AndyBritoS/DC_Motor_Controller/Released Files/ESC_rev0_Back.jpg

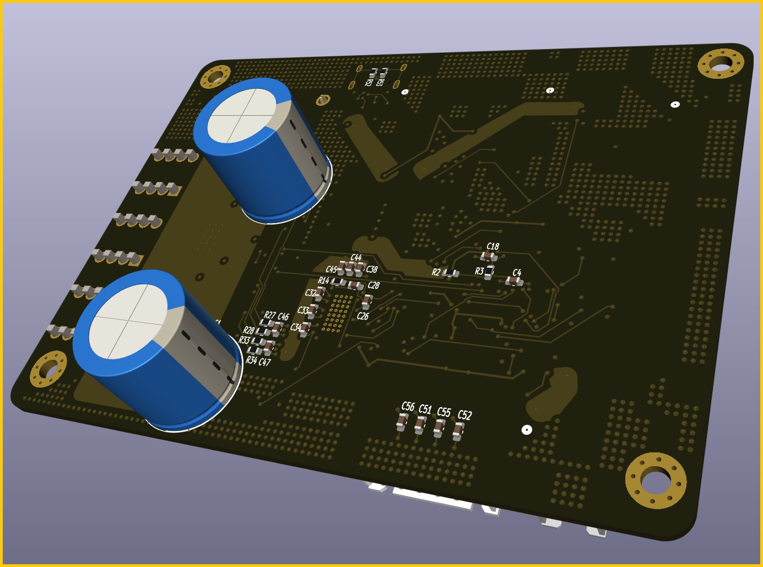
Released Files/ESC_rev0_Back.jpg
