AndyBritoS/DC_Motor_Controller/Released Files/ESC_rev0_RayTracing.jpg

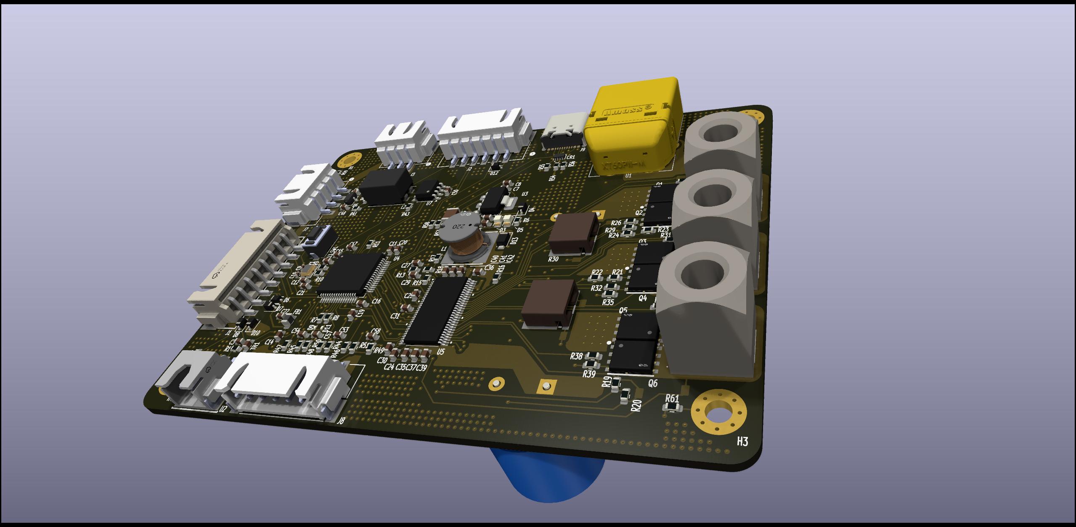
Released Files/ESC_rev0_RayTracing.jpg
