AndyBritoS/DC_Motor_Controller/README.md

# DC_Motor_Controller
DC Motor Controller PCB Project files

This project was made following the PCB Design Mastery course from Fresu Electronics (https://www.fresuelectronics.com/) and it is for demonstration purpose only. The hardware was not built or tested. Some design aspects were ignored.
