AndyBritoS/DC_Motor_Controller/Released Files/ESC_rev0_Front.jpg

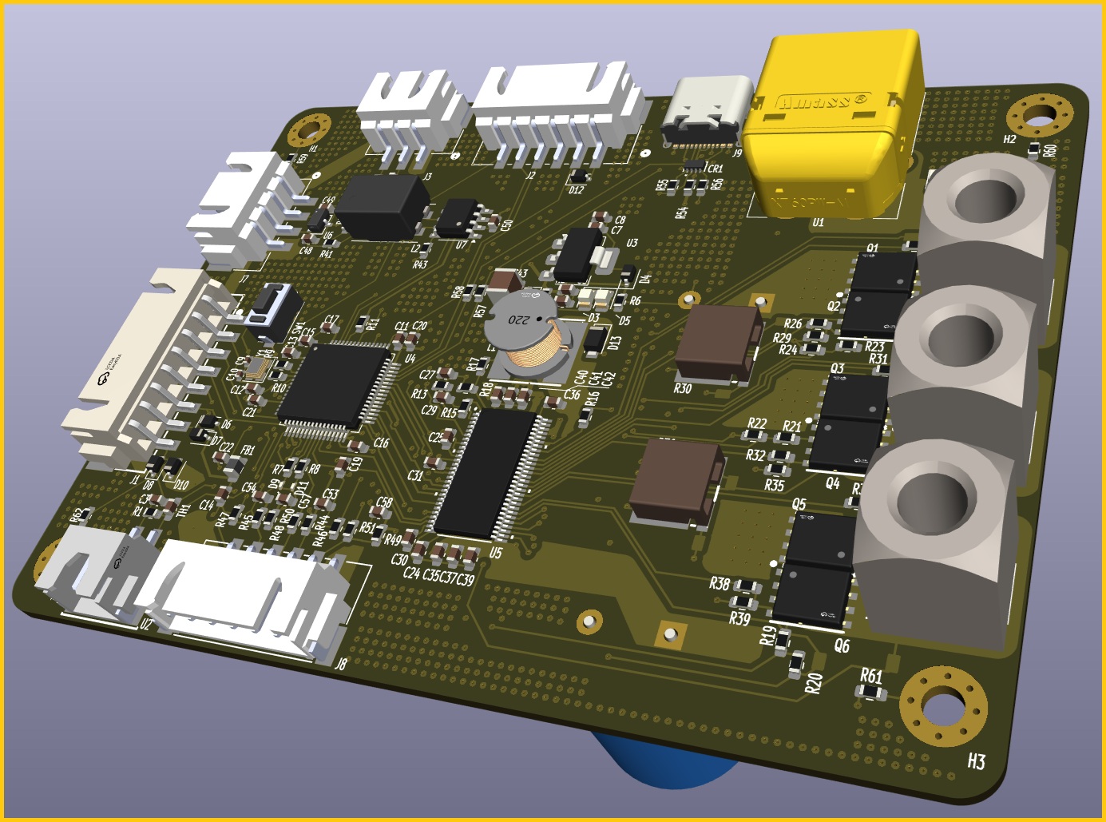
Released Files/ESC_rev0_Front.jpg
