AndyBritoS/DC_Motor_Controller/Released Files/ESC_rev0_RayTracNoSilk.jpg

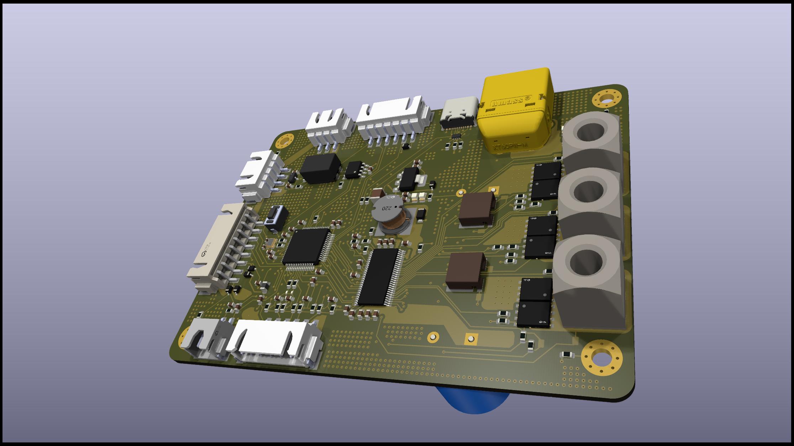
Released Files/ESC_rev0_RayTracNoSilk.jpg
