AndyBritoS/DC_Motor_Controller/Released Files/Layer 1 - Front.png

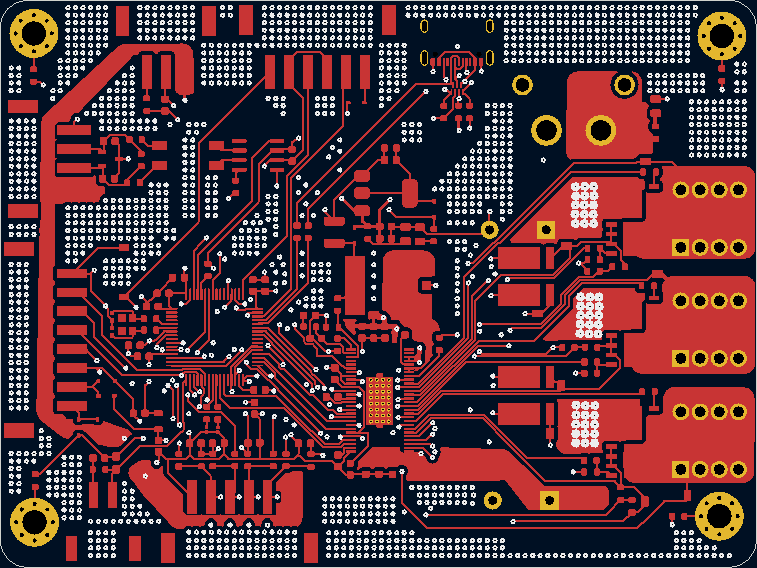
Released Files/Layer 1 - Front.png
