AndyBritoS/DC_Motor_Controller/Released Files/Layer 2 - Inner GND.png

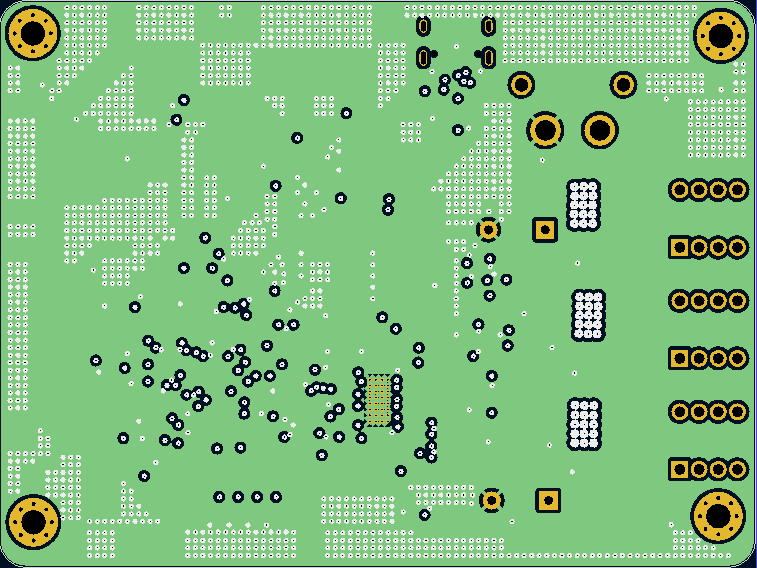
Released Files/Layer 2 - Inner GND.png
