AndyBritoS/DC_Motor_Controller/Released Files/Layer 4 - Back.png

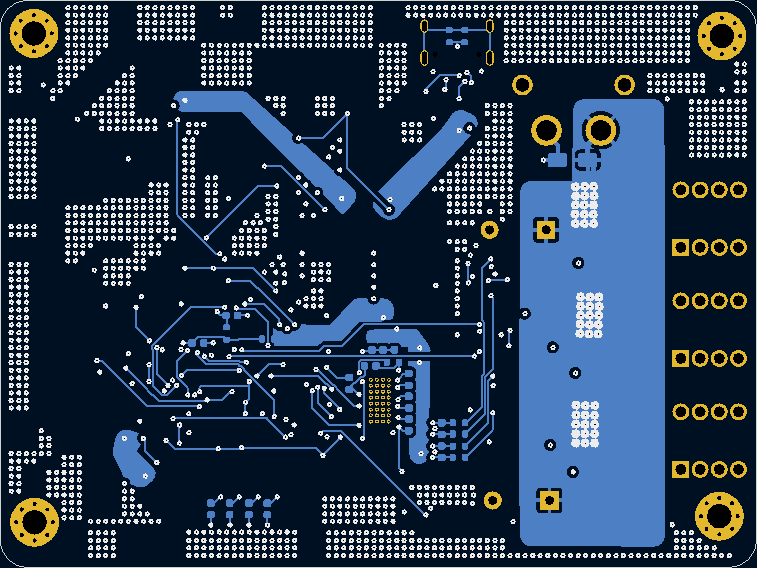
Released Files/Layer 4 - Back.png
