AndyBritoS/DC_Motor_Controller/Design Files/ESC_rev0/ESC_rev0.kicad_pcb

## KiCad design Design Files/ESC_rev0/ESC_rev0.kicad_pcb (2025-01-27)

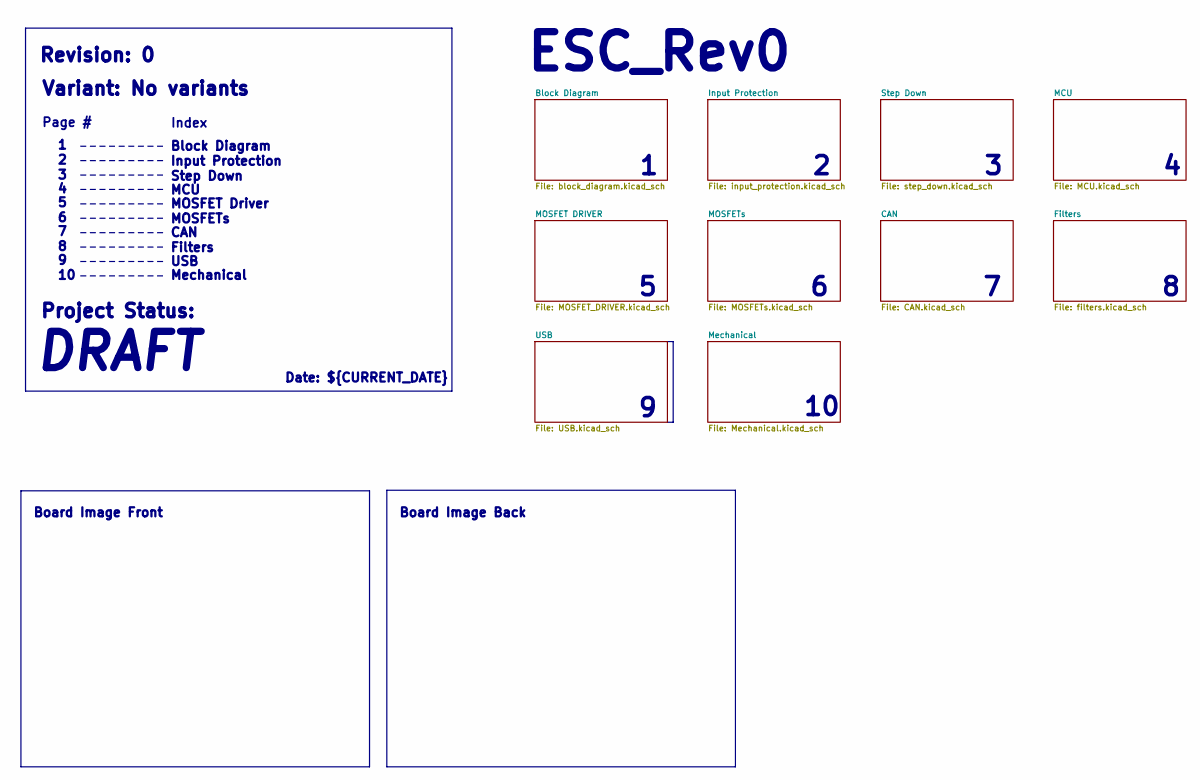
[picture p8: schematic ESC_rev0.kicad_sch]

Notes on the sheet:
MOSFET Driver
${TITLE}
Filters
Block Diagram
Revision: ${REVISION}
USB
Index
DRAFT
Mechanical
Page #
MOSFETs
Step Down
Variant: No variants
CAN
Input Protection
MCU
Board Image Front
Date: ${CURRENT_DATE}
Board Image Back
Project Status:

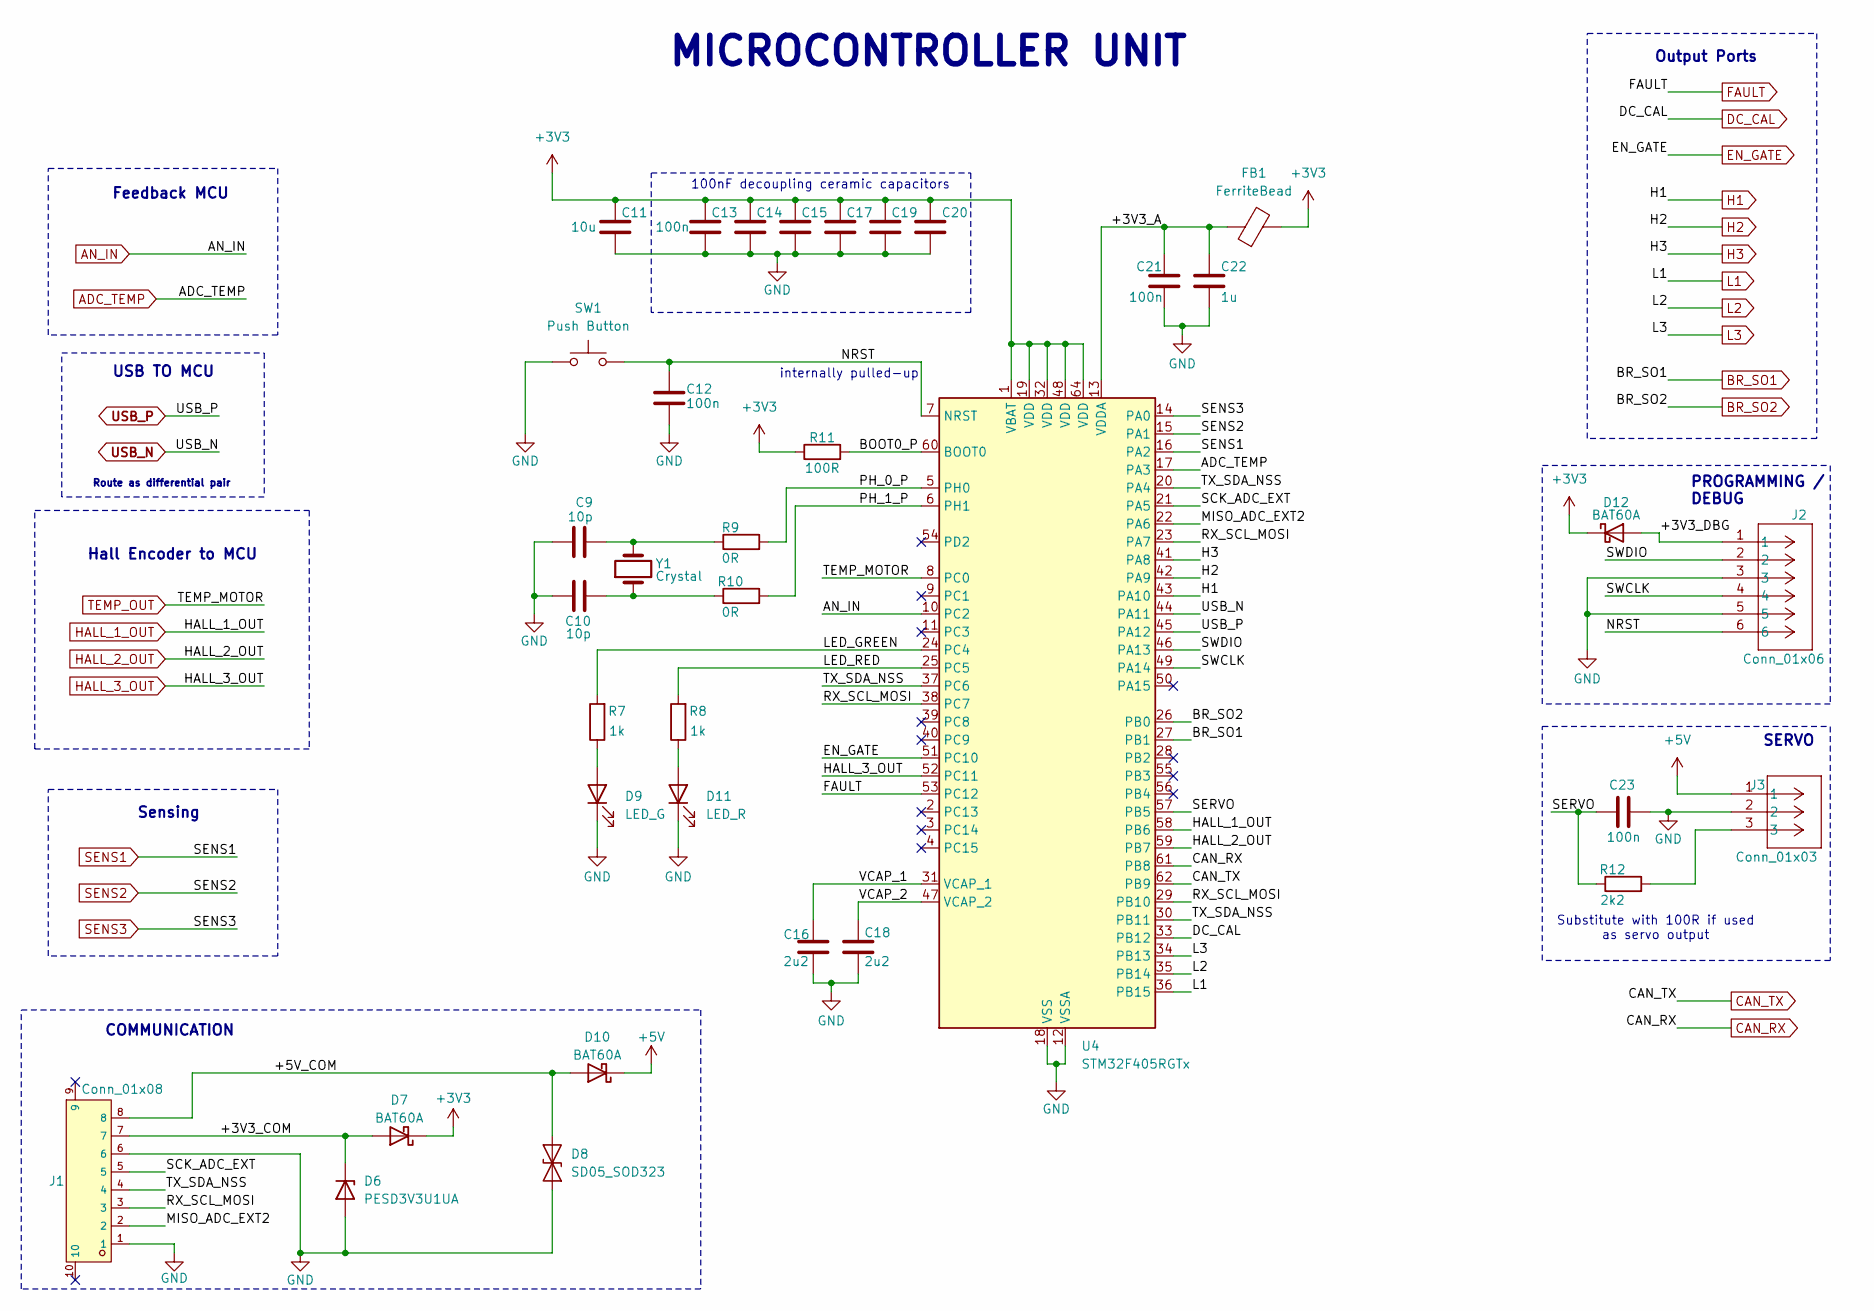
[picture p9: schematic MCU.kicad_sch, MICROCONTROLLER UNIT]

Parts:
C9, C10: 10p; C_0402_1005Metric
C11: 10u; C_0603_1608Metric
C12, C13, C14, C15, C17, C19, C20, C21, C23: 100n; C_0603_1608Metric
C16, C18: 2u2; C_0603_1608Metric
C22: 1u; C_0603_1608Metric
D6: PESD3V3U1UA; D_SOD-323F
D7, D10, D12: BAT60A; D_SOD-323
D8: SD05_SOD323; D_SOD-323
D9: LED_G; LED_0201_0603Metric
D11: LED_R; LED_0201_0603Metric
FB1: FerriteBead; L_0805_2012Metric
J1: Conn_01x08; CONN-SMD_8P-P2.50_HX25003-8AWB; LCSC C442367
J2: Conn_01x06; CONN_S6B-XH-SM4-TB_JST
J3: Conn_01x03; CONN3_S3B-XH_JST
R7, R8: 1k; R_0603_1608Metric
R9, R10: 0R; R_0603_1608Metric
R11: 100R; R_0603_1608Metric
R12: 2k2; R_0603_1608Metric
SW1: Push Button; SW_PTS636_SM43J_SMTR_LFS
U4: STM32F405RGTx; LQFP-64_10x10mm_P0.5mm
Y1: Crystal; Crystal_SMD_2520-4Pin_2.5x2.0mm

Connections:
+3V3: C11.1, C13.1, C14.1, C15.1, C17.1, C19.1, C20.1, D7.1 (K), D12.1 (K), FB1.2, R11.1, U4.1 (VBAT), U4.19 (VDD), U4.32 (VDD), U4.48 (VDD), U4.64 (VDD); also elsewhere on the board
+5V: D10.1 (K), J3.1; also elsewhere on the board
/MCU/+3V3_A: C21.1, C22.1, FB1.1, U4.13 (VDDA)
/MCU/+3V3_COM: D6.1 (K), D7.2 (A), J1.7
/MCU/+3V3_DBG: D12.2 (A), J2.1
/MCU/+5V_COM: D8.2 (A2), D10.2 (A), J1.8
/MCU/BOOT0_P: R11.2, U4.60 (BOOT0)
/MCU/LED_GREEN: R7.2, U4.24 (PC4)
/MCU/LED_RED: R8.2, U4.25 (PC5)
/MCU/MISO_ADC_EXT2: J1.2, U4.22 (PA6)
/MCU/NRST: C12.1, J2.6, SW1.2, U4.7 (NRST)
/MCU/PH_0_P: R9.2, U4.5 (PH0)
/MCU/PH_1_P: R10.2, U4.6 (PH1)
/MCU/RX_SCL_MOSI: J1.3, U4.23 (PA7), U4.29 (PB10), U4.38 (PC7)
/MCU/SCK_ADC_EXT: J1.5, U4.21 (PA5)
/MCU/SERVO: C23.1, R12.1, U4.57 (PB5)
/MCU/SWCLK: J2.4, U4.49 (PA14)
/MCU/SWDIO: J2.2, U4.46 (PA13)
/MCU/TX_SDA_NSS: J1.4, U4.20 (PA4), U4.30 (PB11), U4.37 (PC6)
/MCU/VCAP_1: C16.1, U4.31 (VCAP_1)
/MCU/VCAP_2: C18.1, U4.47 (VCAP_2)
ADC_TEMP: U4.17 (PA3); also elsewhere on the board
AN_IN: U4.10 (PC2); also elsewhere on the board
BR_SO1: U4.27 (PB1); also elsewhere on the board
BR_SO2: U4.26 (PB0); also elsewhere on the board
CAN_RX: U4.61 (PB8); also elsewhere on the board
CAN_TX: U4.62 (PB9); also elsewhere on the board
DC_CAL: U4.33 (PB12); also elsewhere on the board
EN_GATE: U4.51 (PC10); also elsewhere on the board
FAULT: U4.53 (PC12); also elsewhere on the board
GND: C9.1, C10.1, C11.2, C12.2, C13.2, C14.2, C15.2, C16.2, C17.2, C18.2, C19.2, C20.2, C21.2, C22.2, C23.2, D6.2 (A), D8.1 (A1), D9.1 (K), D11.1 (K), J1.1, J1.6, J2.3, J2.5, J3.2, SW1.1, U4.12 (VSSA), U4.18 (VSS), U4.63 (VSS); also elsewhere on the board
H1: U4.43 (PA10); also elsewhere on the board
H2: U4.42 (PA9); also elsewhere on the board
H3: U4.41 (PA8); also elsewhere on the board
HALL_1_OUT: U4.58 (PB6); also elsewhere on the board
HALL_2_OUT: U4.59 (PB7); also elsewhere on the board
HALL_3_OUT: U4.52 (PC11); also elsewhere on the board
L1: U4.36 (PB15); also elsewhere on the board
L2: U4.35 (PB14); also elsewhere on the board
L3: U4.34 (PB13); also elsewhere on the board
unnamed: C9.2, R9.1, Y1.2
unnamed: C10.2, R10.1, Y1.1
unnamed: D9.2 (A), R7.1
unnamed: D11.2 (A), R8.1
unnamed: J3.3, R12.2
SENS1: U4.16 (PA2); also elsewhere on the board
SENS2: U4.15 (PA1); also elsewhere on the board
SENS3: U4.14 (PA0); also elsewhere on the board
TEMP_OUT: U4.8 (PC0); also elsewhere on the board
USB_N: U4.44 (PA11); also elsewhere on the board
USB_P: U4.45 (PA12); also elsewhere on the board

Notes on the sheet:
Substitute with 100R if used as servo output
internally pulled-up
Hall Encoder to MCU
Output Ports
USB TO MCU
Feedback MCU
PROGRAMMING / DEBUG
SERVO
${TITLE}
COMMUNICATION
100nF decoupling ceramic capacitors
Route as differential pair
Sensing

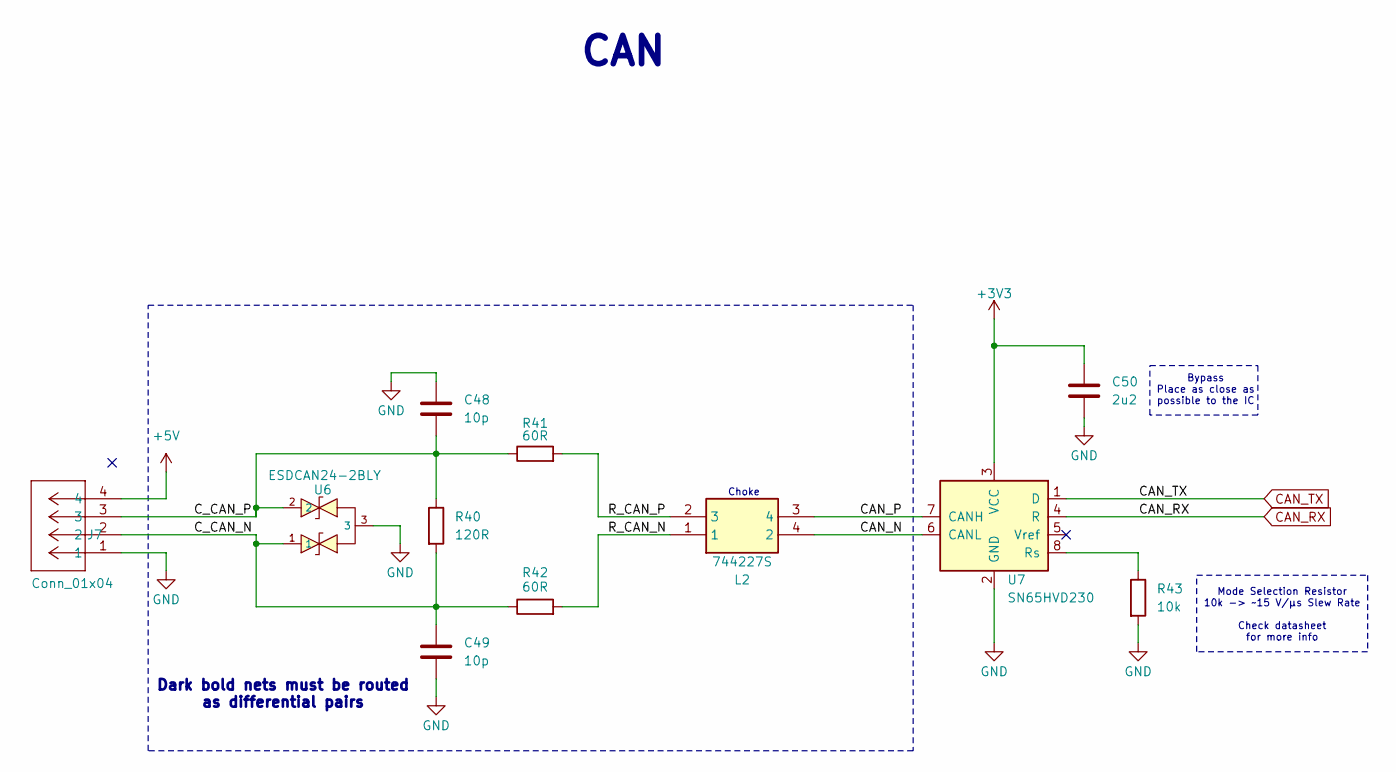
[picture p10: schematic CAN.kicad_sch]

Parts:
C48, C49: 10p; C_0603_1608Metric
C50: 2u2; C_0603_1608Metric
J7: Conn_01x04; CONN4_S4B-XH_JST
L2: 744227S; WE-SL274; Manufacturer_Part_Number 744227S; Mouser Part Number 710-744227S
R40: 120R; R_0603_1608Metric
R41, R42: 60R; R_0603_1608Metric
R43: 10k; R_0603_1608Metric
U6: ESDCAN24-2BLY; SOT-23-3_L3.0-W1.7-P0.95-LS2.9-BR; LCSC C246766
U7: SN65HVD230; SOIC-8_3.9x4.9mm_P1.27mm

Connections:
+3V3: C50.1, U7.3 (VCC); also elsewhere on the board
+5V: J7.4; also elsewhere on the board
/CAN/CAN_N: L2.4 (2), U7.6 (CANL)
/CAN/CAN_P: L2.3 (4), U7.7 (CANH)
/CAN/C_CAN_N: C49.1, J7.2, R40.2, R42.1, U6.1
/CAN/C_CAN_P: C48.2, J7.3, R40.1, R41.1, U6.2
/CAN/R_CAN_N: L2.1, R42.2
/CAN/R_CAN_P: L2.2 (3), R41.2
CAN_RX: U7.4 (R); also elsewhere on the board
CAN_TX: U7.1 (D); also elsewhere on the board
GND: C48.1, C49.2, C50.2, J7.1, R43.2, U6.3, U7.2 (GND); also elsewhere on the board
unnamed: R43.1, U7.8 (Rs)

Notes on the sheet:
Dark bold nets must be routed as differential pairs
Mode Selection Resistor 10k -> ~15 V/µs Slew Rate Check datasheet for more info
Bypass Place as close as possible to the IC
${TITLE}
Choke

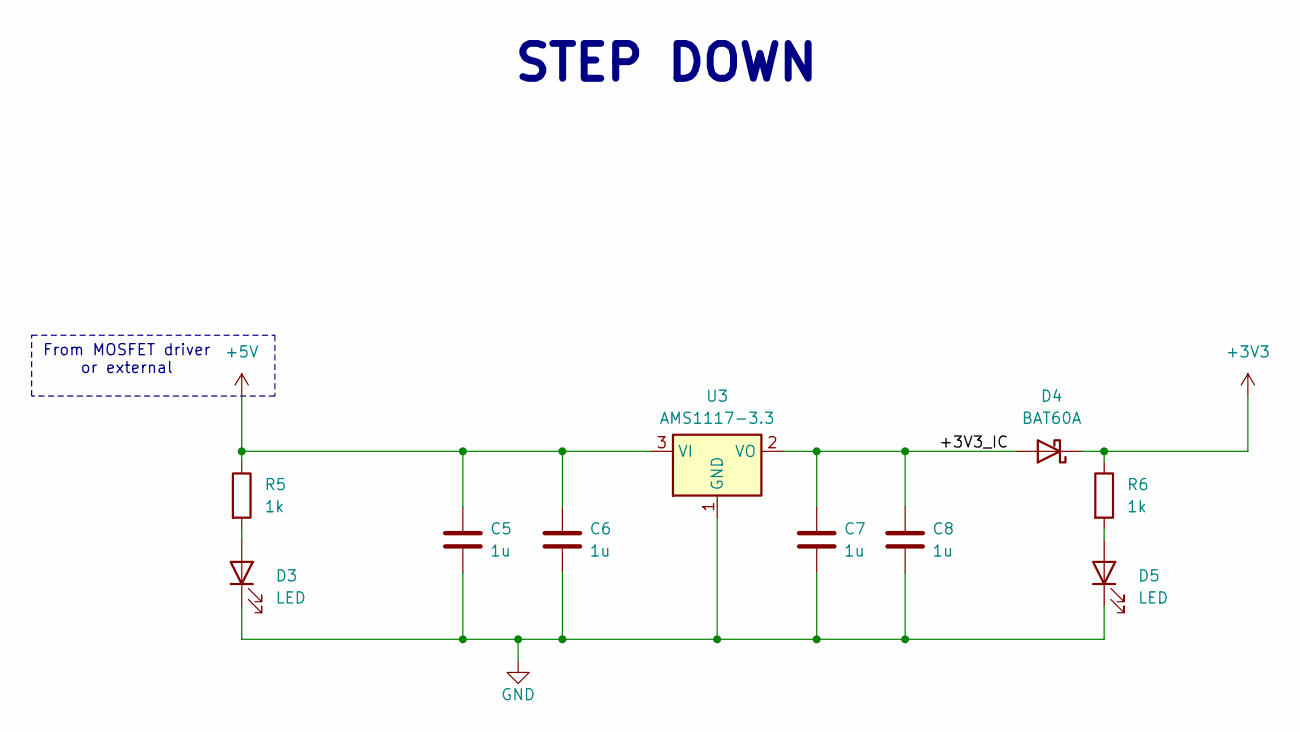
[picture p11: schematic step_down.kicad_sch, STEP DOWN]

Parts:
C5, C6, C7, C8: 1u; C_0603_1608Metric
D3, D5: LED; LED_0805_2012Metric
D4: BAT60A; D_SOD-323
R5, R6: 1k; R_0603_1608Metric
U3: AMS1117-3.3; SOT-223-3_TabPin2

Connections:
+3V3: D4.1 (K), R6.1; also elsewhere on the board
+5V: C5.1, C6.1, R5.1, U3.3 (VI); also elsewhere on the board
/Step Down/+3V3_IC: C7.1, C8.1, D4.2 (A), U3.2 (VO)
GND: C5.2, C6.2, C7.2, C8.2, D3.1 (K), D5.1 (K), U3.1 (GND); also elsewhere on the board
unnamed: D3.2 (A), R5.2
unnamed: D5.2 (A), R6.2

Notes on the sheet:
From MOSFET driver or external
${TITLE}

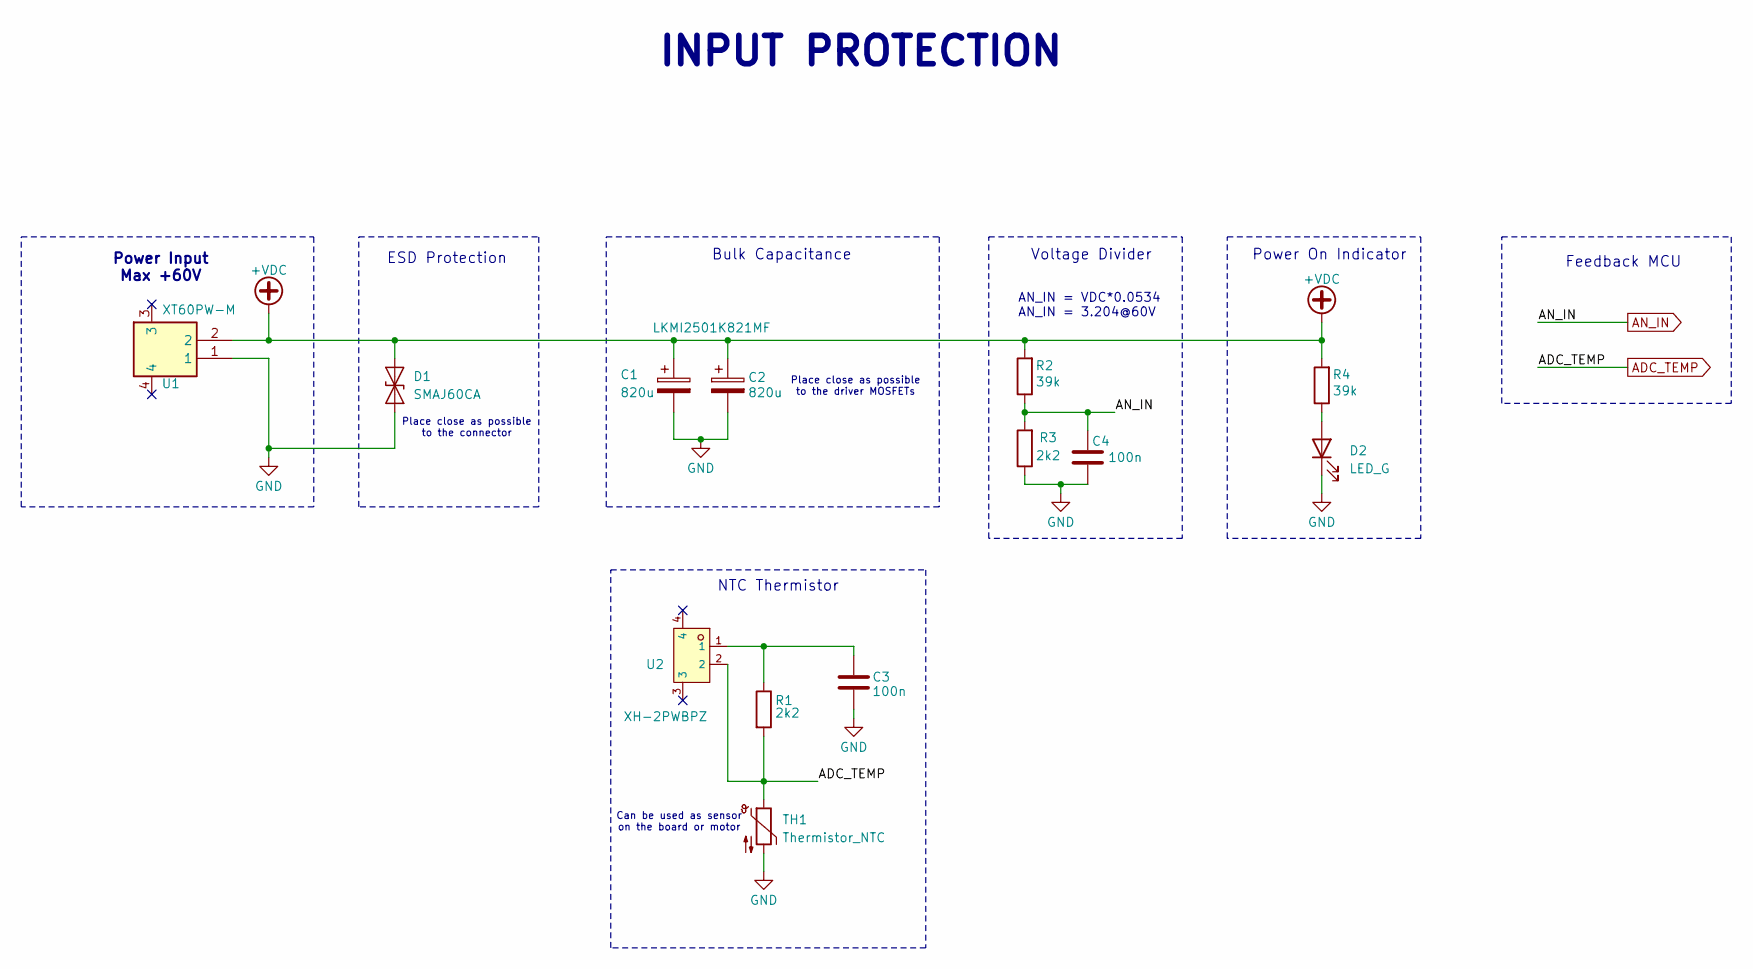
[picture p12: schematic input_protection.kicad_sch, INPUT PROTECTION]

Parts:
C1, C2: 820u; CP_Radial_D16.0mm_P7.50mm
C3, C4: 100n; C_0603_1608Metric
D1: SMAJ60CA; D_SMA
D2: LED_G; LED_0805_2012Metric
R1, R3: 2k2; R_0603_1608Metric
R2, R4: 39k; R_0603_1608Metric
TH1: Thermistor_NTC; C_0603_1608Metric_Pad1.08x0.95mm_HandSolder
U1: XT60PW-M; XT60PWM; Manufacturer_Part_Number XT60PW-M; LCSC C431092
U2: XH-2PWBPZ; CONN-SMD_XH-2PWBPZ; LCSC C2687444

Connections:
+VDC: C1.1, C2.1, D1.2 (A2), R2.2, R4.2, U1.2; also elsewhere on the board
ADC_TEMP: R1.2, TH1.1, U2.2; also elsewhere on the board
AN_IN: C4.1, R2.1, R3.2; also elsewhere on the board
GND: C1.2, C2.2, C3.2, C4.2, D1.1 (A1), D2.1 (K), R3.1, TH1.2, U1.1; also elsewhere on the board
unnamed: C3.1, R1.1, U2.1
unnamed: D2.2 (A), R4.1

Notes on the sheet:
Place close as possible to the driver MOSFETs
Place close as possible to the connector
Voltage Divider
AN_IN = VDC*0.0534 AN_IN = 3.204@60V
Can be used as sensor on the board or motor
Feedback MCU
Power Input Max +60V
${TITLE}
NTC Thermistor
Power On Indicator
ESD Protection
Bulk Capacitance

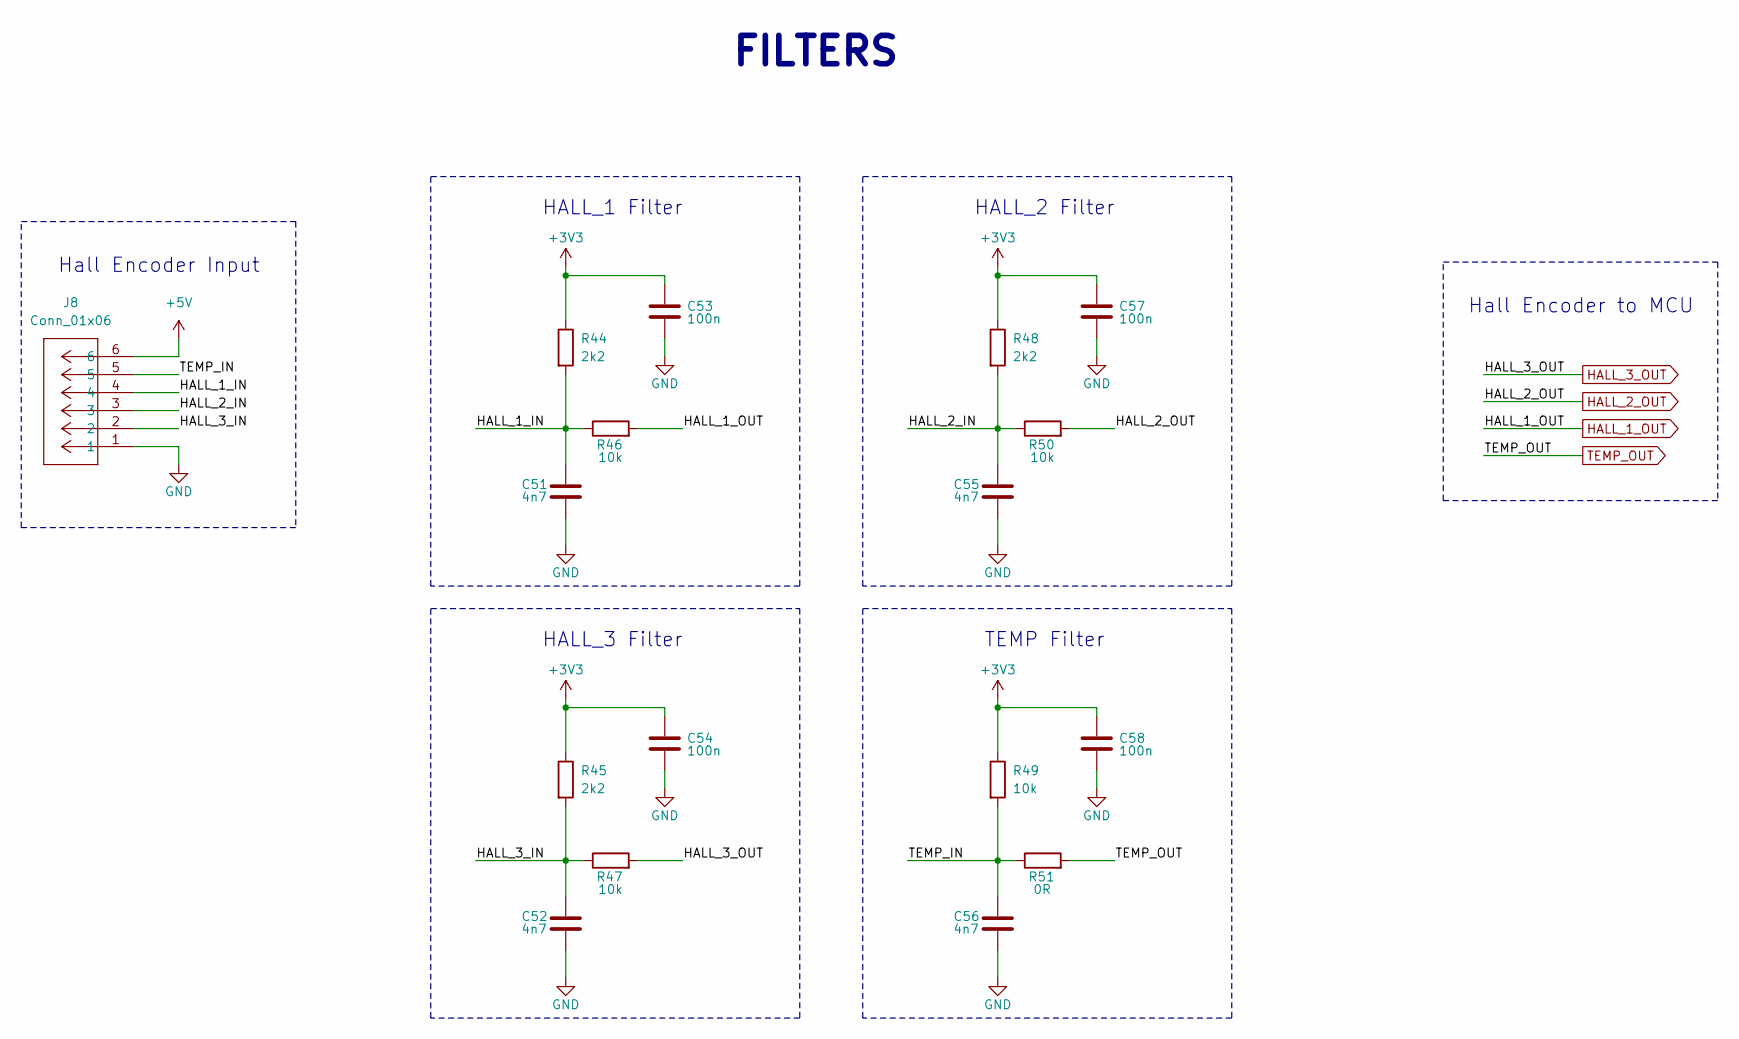
[picture p13: schematic filters.kicad_sch]

Parts:
C51, C52, C55, C56: 4n7; C_0603_1608Metric
C53, C54, C57, C58: 100n; C_0603_1608Metric
J8: Conn_01x06; CONN_S6B-XH-SM4-TB_JST
R44, R45, R48: 2k2; R_0603_1608Metric
R46, R47, R49, R50: 10k; R_0603_1608Metric
R51: 0R; R_0603_1608Metric

Connections:
+3V3: C53.1, C54.1, C57.1, C58.1, R44.1, R45.1, R48.1, R49.1; also elsewhere on the board
+5V: J8.6; also elsewhere on the board
/Filters/HALL_1_IN: C51.1, J8.4, R44.2, R46.1
/Filters/HALL_2_IN: C55.1, J8.3, R48.2, R50.1
/Filters/HALL_3_IN: C52.1, J8.2, R45.2, R47.1
/Filters/TEMP_IN: C56.1, J8.5, R49.2, R51.1
GND: C51.2, C52.2, C53.2, C54.2, C55.2, C56.2, C57.2, C58.2, J8.1; also elsewhere on the board
HALL_1_OUT: R46.2; also elsewhere on the board
HALL_2_OUT: R50.2; also elsewhere on the board
HALL_3_OUT: R47.2; also elsewhere on the board
TEMP_OUT: R51.2; also elsewhere on the board

Notes on the sheet:
HALL_1 Filter
Hall Encoder Input
HALL_3 Filter
HALL_2 Filter
${TITLE}
TEMP Filter
Hall Encoder to MCU

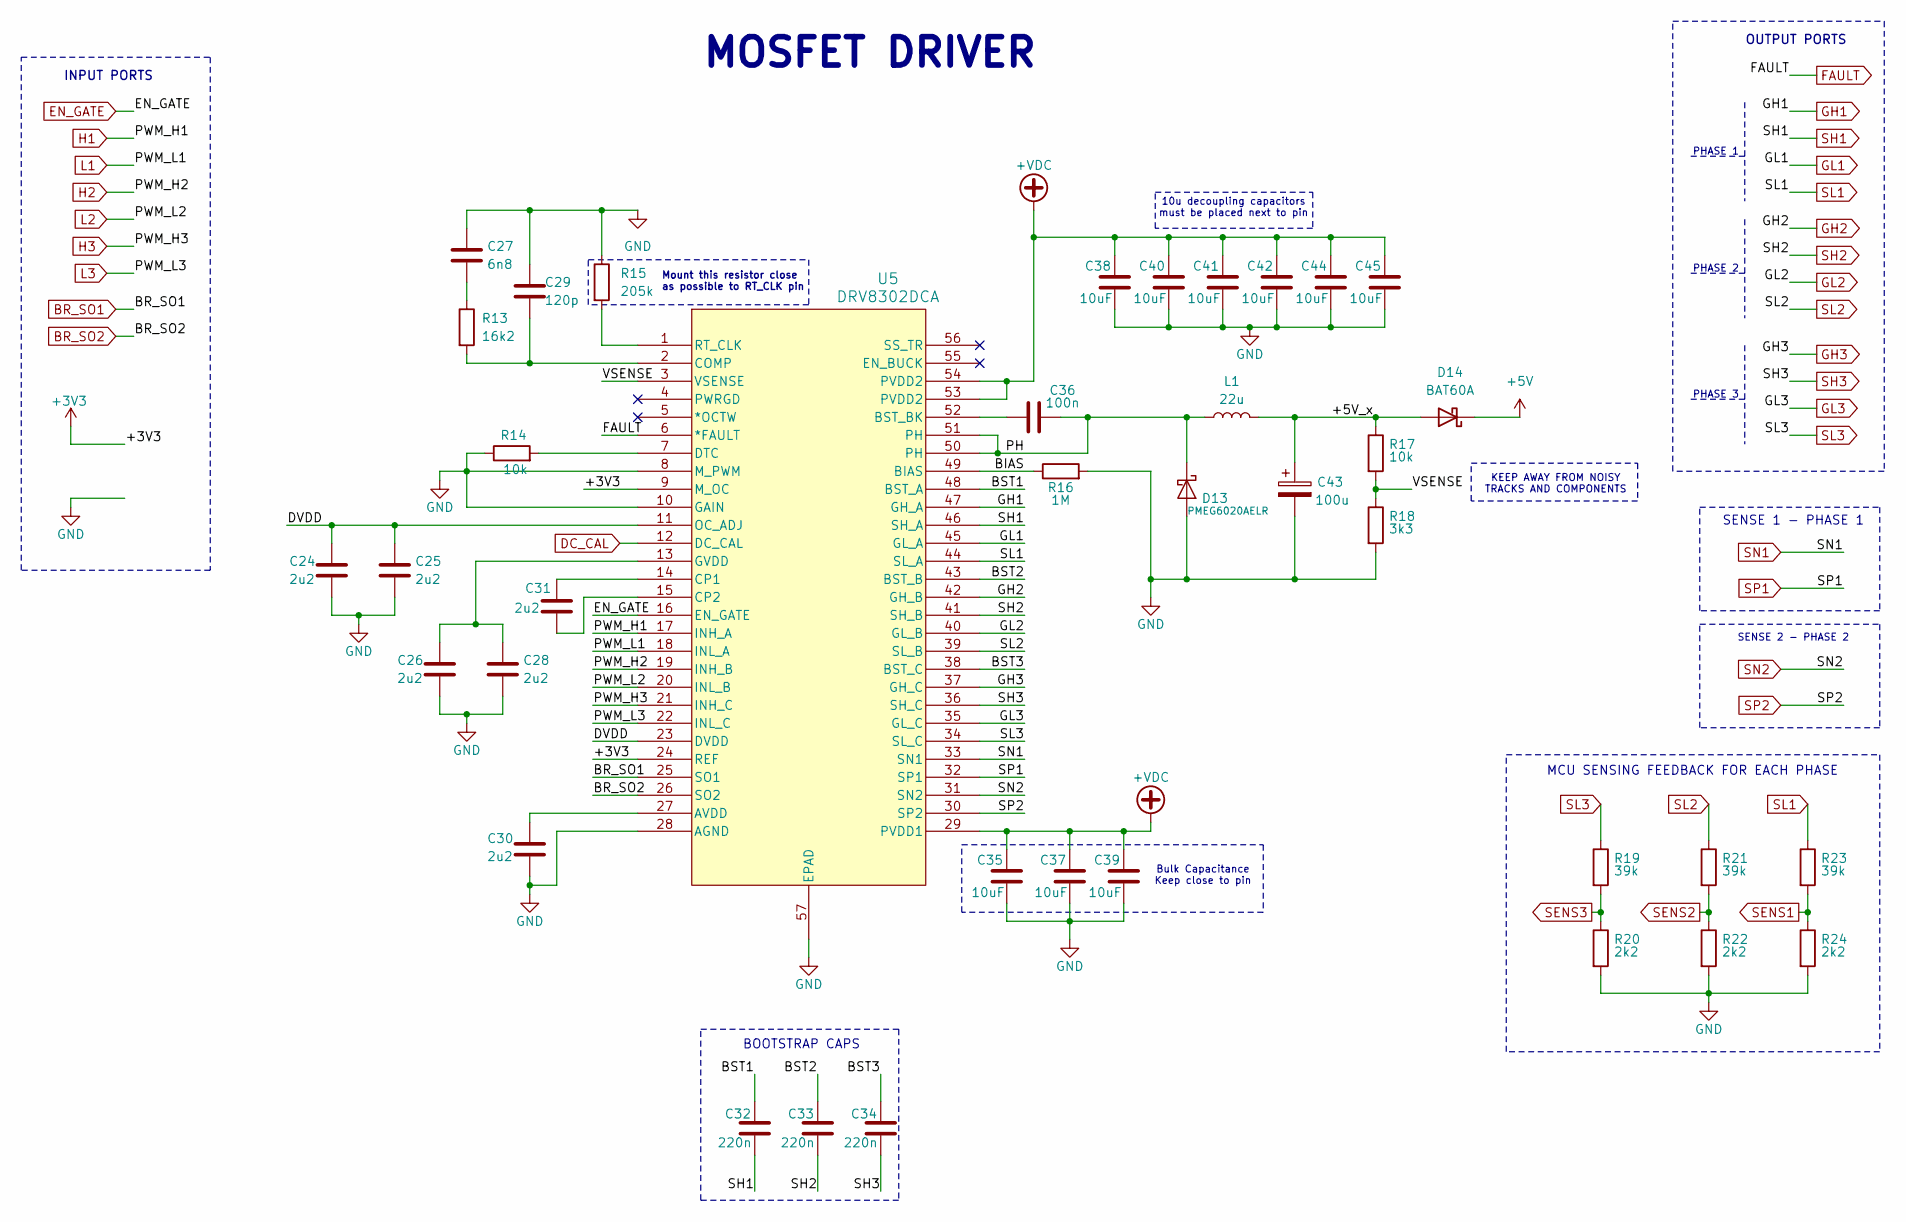
[picture p14: schematic MOSFET_DRIVER.kicad_sch, MOSFET DRIVER]

Parts:
C24, C25, C26, C28, C30, C31: 2u2; C_0603_1608Metric
C27: 6n8; C_0603_1608Metric
C29: 120p; C_0603_1608Metric
C32, C33, C34: 220n; C_0603_1608Metric
C35, C37, C38, C39, C40, C41, C42, C44, C45: 10uF; C_0603_1608Metric
C36: 100n; C_0603_1608Metric
C43: 100u; C_1210_3225Metric
D13: PMEG6020AELR; Nexperia_CFP3_SOD-123W
D14: BAT60A; D_SOD-323
L1: 22u; IND-SMD_L7.8-W7.8_SDR0805
R13: 16k2; R_0603_1608Metric
R14, R17: 10k; R_0603_1608Metric
R15: 205k; R_0603_1608Metric
R16: 1M; R_0603_1608Metric
R18: 3k3; R_0603_1608Metric
R19, R21, R23: 39k; R_0603_1608Metric
R20, R22, R24: 2k2; R_0603_1608Metric
U5: DRV8302DCA; DCA56_6P35X3P61

Connections:
+3V3: U5.9 (M_OC), U5.24 (REF); also elsewhere on the board
+5V: D14.1 (K); also elsewhere on the board
+VDC: C35.1, C37.1, C38.1, C39.1, C40.1, C41.1, C42.1, C44.1, C45.1, U5.29 (PVDD1), U5.53 (PVDD2), U5.54 (PVDD2); also elsewhere on the board
/MOSFET DRIVER/+5V_x: C43.1, D14.2 (A), L1.2, R17.1
/MOSFET DRIVER/BIAS: R16.1, U5.49 (BIAS)
/MOSFET DRIVER/BST1: C32.1, U5.48 (BST_A)
/MOSFET DRIVER/BST2: C33.1, U5.43 (BST_B)
/MOSFET DRIVER/BST3: C34.1, U5.38 (BST_C)
/MOSFET DRIVER/DVDD: C24.1, C25.1, U5.11 (OC_ADJ), U5.23 (DVDD)
/MOSFET DRIVER/PH: C36.2, D13.1 (K), L1.1, U5.50 (PH), U5.51 (PH)
/MOSFET DRIVER/VSENSE: R17.2, R18.1, U5.3 (VSENSE)
BR_SO1: U5.25 (SO1); also elsewhere on the board
BR_SO2: U5.26 (SO2); also elsewhere on the board
DC_CAL: U5.12 (DC_CAL); also elsewhere on the board
EN_GATE: U5.16 (EN_GATE); also elsewhere on the board
FAULT: U5.6 (*FAULT); also elsewhere on the board
GH1: U5.47 (GH_A); also elsewhere on the board
GH2: U5.42 (GH_B); also elsewhere on the board
GH3: U5.37 (GH_C); also elsewhere on the board
GL1: U5.45 (GL_A); also elsewhere on the board
GL2: U5.40 (GL_B); also elsewhere on the board
GL3: U5.35 (GL_C); also elsewhere on the board
GND: C24.2, C25.2, C26.2, C27.1, C28.2, C29.1, C30.2, C35.2, C37.2, C38.2, C39.2, C40.2, C41.2, C42.2, C43.2, C44.2, C45.2, D13.2 (A), R14.1, R15.1, R16.2, R18.2, R20.2, R22.2, R24.2, U5.8 (M_PWM), U5.10 (GAIN), U5.28 (AGND), U5.57 (EPAD), U5.V; also elsewhere on the board
H1: U5.17 (INH_A); also elsewhere on the board
H2: U5.19 (INH_B); also elsewhere on the board
H3: U5.21 (INH_C); also elsewhere on the board
L1: U5.18 (INL_A); also elsewhere on the board
L2: U5.20 (INL_B); also elsewhere on the board
L3: U5.22 (INL_C); also elsewhere on the board
unnamed: C27.2, R13.1
unnamed: C30.1, U5.27 (AVDD)
unnamed: C36.1, U5.52 (BST_BK)
unnamed: C29.2, R13.2, U5.2 (COMP)
unnamed: C31.1, U5.14 (CP1)
unnamed: C31.2, U5.15 (CP2)
unnamed: R14.2, U5.7 (DTC)
unnamed: C26.1, C28.1, U5.13 (GVDD)
unnamed: R15.2, U5.1 (RT_CLK)
SENS1: R23.2, R24.1; also elsewhere on the board
SENS2: R21.2, R22.1; also elsewhere on the board
SENS3: R19.2, R20.1; also elsewhere on the board
SH1: C32.2, U5.46 (SH_A); also elsewhere on the board
SH2: C33.2, U5.41 (SH_B); also elsewhere on the board
SH3: C34.2, U5.36 (SH_C); also elsewhere on the board
SL1: R23.1, U5.44 (SL_A); also elsewhere on the board
SL2: R21.1, U5.39 (SL_B); also elsewhere on the board
SL3: R19.1, U5.34 (SL_C); also elsewhere on the board
SN1: U5.33 (SN1); also elsewhere on the board
SN2: U5.31 (SN2); also elsewhere on the board
SP1: U5.32 (SP1); also elsewhere on the board
SP2: U5.30 (SP2); also elsewhere on the board

Notes on the sheet:
Mount this resistor close as possible to RT_CLK pin
PHASE 2
SENSE 1 - PHASE 1
SENSE 2 - PHASE 2
10u decoupling capacitors must be placed next to pin
OUTPUT PORTS
MCU SENSING FEEDBACK FOR EACH PHASE
INPUT PORTS
${TITLE}
PHASE 1
Bulk Capacitance Keep close to pin
BOOTSTRAP CAPS
PHASE 3
KEEP AWAY FROM NOISY TRACKS AND COMPONENTS

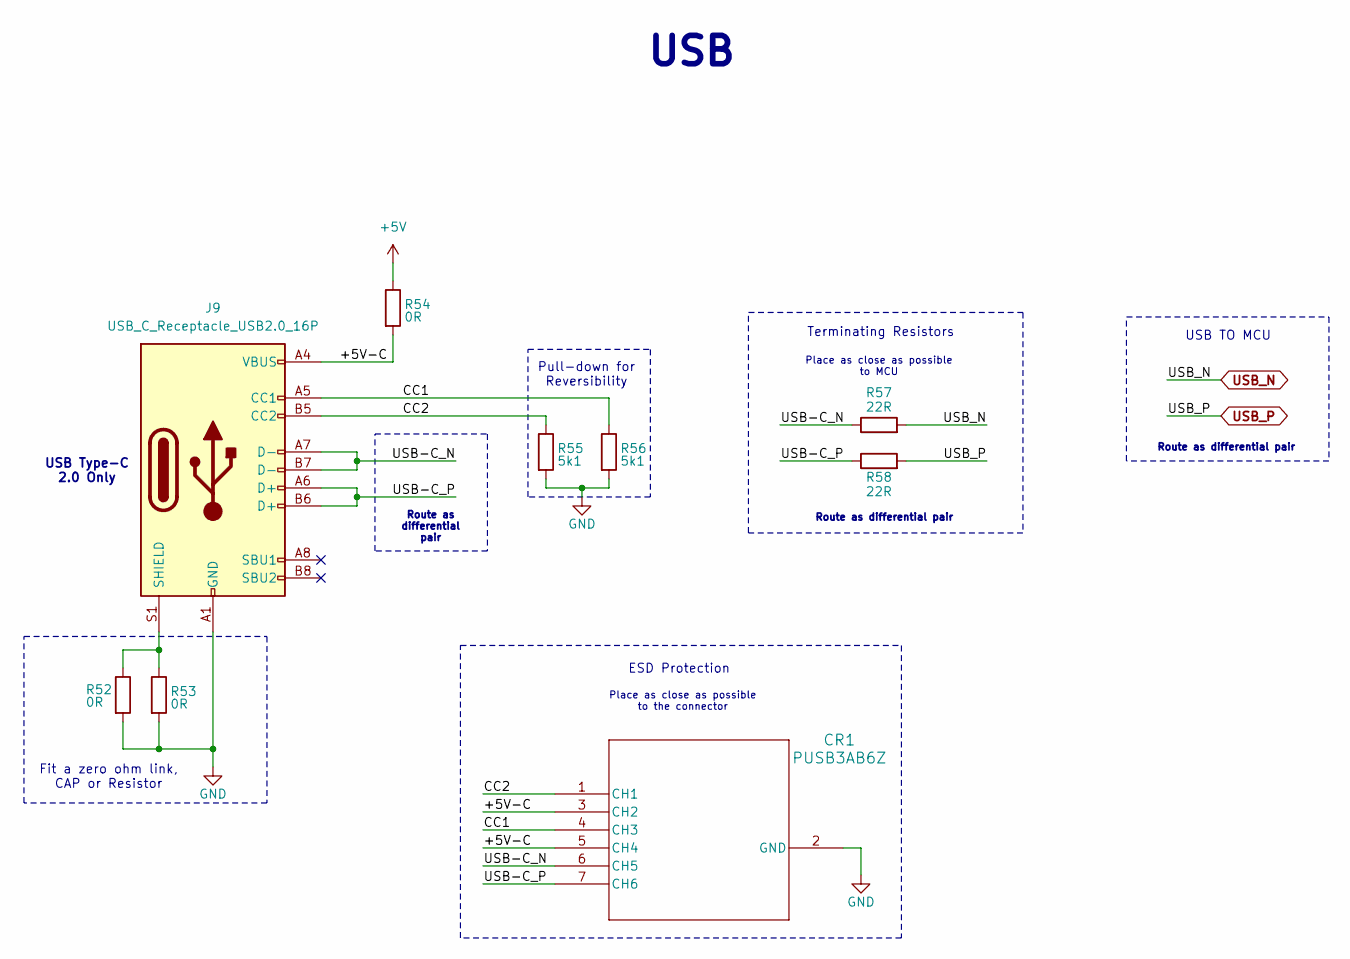
[picture p15: schematic USB.kicad_sch]

Parts:
CR1: PUSB3AB6Z; PUSB3AB6Z_NEX
J9: USB_C_Receptacle_USB2.0_16P; USB_C_Receptacle_GCT_USB4105-xx-A_16P_TopMnt_Horizontal_mod
R52, R53, R54: 0R; R_0603_1608Metric
R55, R56: 5k1; R_0603_1608Metric
R57, R58: 22R; R_0603_1608Metric

Connections:
+5V: R54.1; also elsewhere on the board
/USB/+5V-C: CR1.3 (CH2), CR1.5 (CH4), J9.A4 (VBUS), J9.A9 (VBUS), J9.B4 (VBUS), J9.B9 (VBUS), R54.2
/USB/CC1: CR1.4 (CH3), J9.A5 (CC1), R56.1
/USB/CC2: CR1.1 (CH1), J9.B5 (CC2), R55.1
/USB/USB-C_N: CR1.6 (CH5), J9.A7 (D-), J9.B7 (D-), R57.1
/USB/USB-C_P: CR1.7 (CH6), J9.A6 (D+), J9.B6 (D+), R58.1
GND: CR1.2 (GND), J9.A1 (GND), J9.A12 (GND), J9.B1 (GND), J9.B12 (GND), R52.2, R53.2, R55.2, R56.2; also elsewhere on the board
unnamed: J9.S1 (SHIELD), R52.1, R53.1
USB_N: R57.2; also elsewhere on the board
USB_P: R58.2; also elsewhere on the board

Notes on the sheet:
ESD Protection
USB TO MCU
Pull-down for Reversibility
Terminating Resistors
Route as differential pair
Place as close as possible to MCU
USB Type-C 2.0 Only
Fit a zero ohm link, CAP or Resistor
Route as differential pair
Place as close as possible to the connector
${TITLE}
