AndyBritoS/DC_Motor_Controller/Design Files/ESC_rev0/ESC_rev0.kicad_pcb

## KiCad design Design Files/ESC_rev0/ESC_rev0.kicad_pcb (continued)

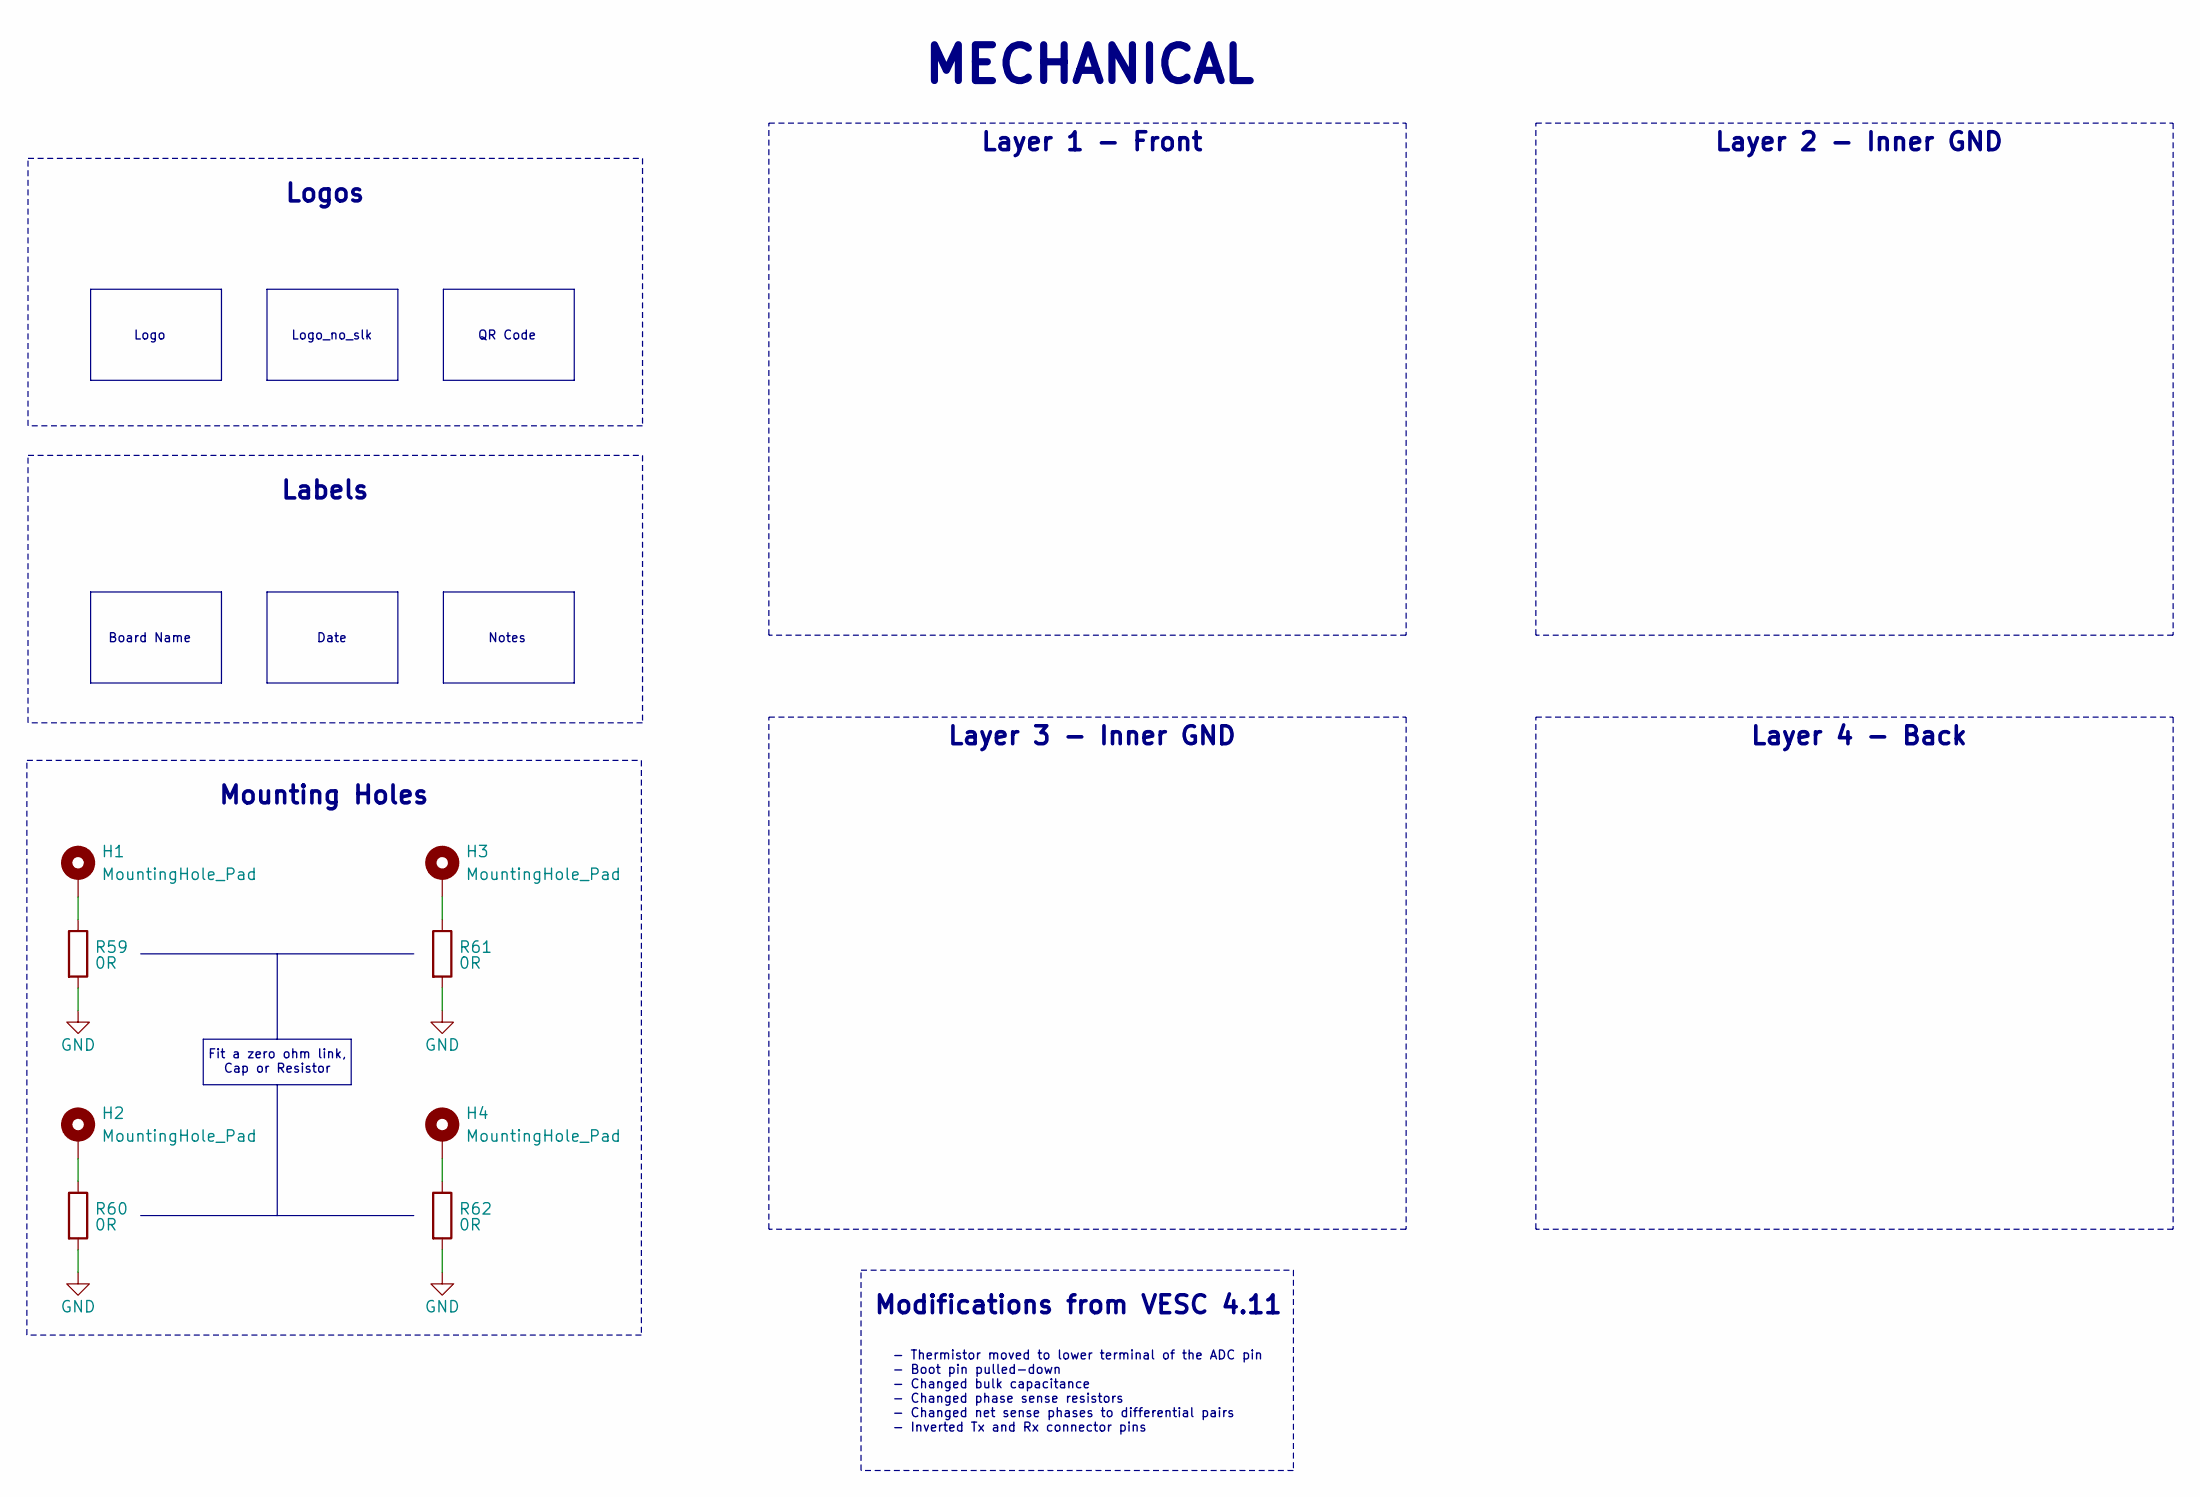
[picture p16: schematic Mechanical.kicad_sch]

Parts:
H1, H2, H3, H4: MountingHole_Pad; MountingHole_3.2mm_M3_Pad_Via
R59, R60, R61, R62: 0R; R_0603_1608Metric

Connections:
GND: R59.2, R60.2, R61.2, R62.2; also elsewhere on the board
unnamed: H1.1, R59.1
unnamed: H2.1, R60.1
unnamed: H3.1, R61.1
unnamed: H4.1, R62.1

Notes on the sheet:
Date
Logo_no_slk
Logos
- Thermistor moved to lower terminal of the ADC pin - Boot pin pulled-down - Changed bulk capacitance - Changed phase sense resistors - Changed net sense phases to differential pairs - Inverted Tx and Rx connector pins
Modifications from VESC 4.11
Labels
QR Code
Mounting Holes
Layer 2 - Inner GND
Notes
Logo
Fit a zero ohm link, Cap or Resistor
Layer 3 - Inner GND
${TITLE}
Layer 4 - Back
Layer 1 - Front
Board Name

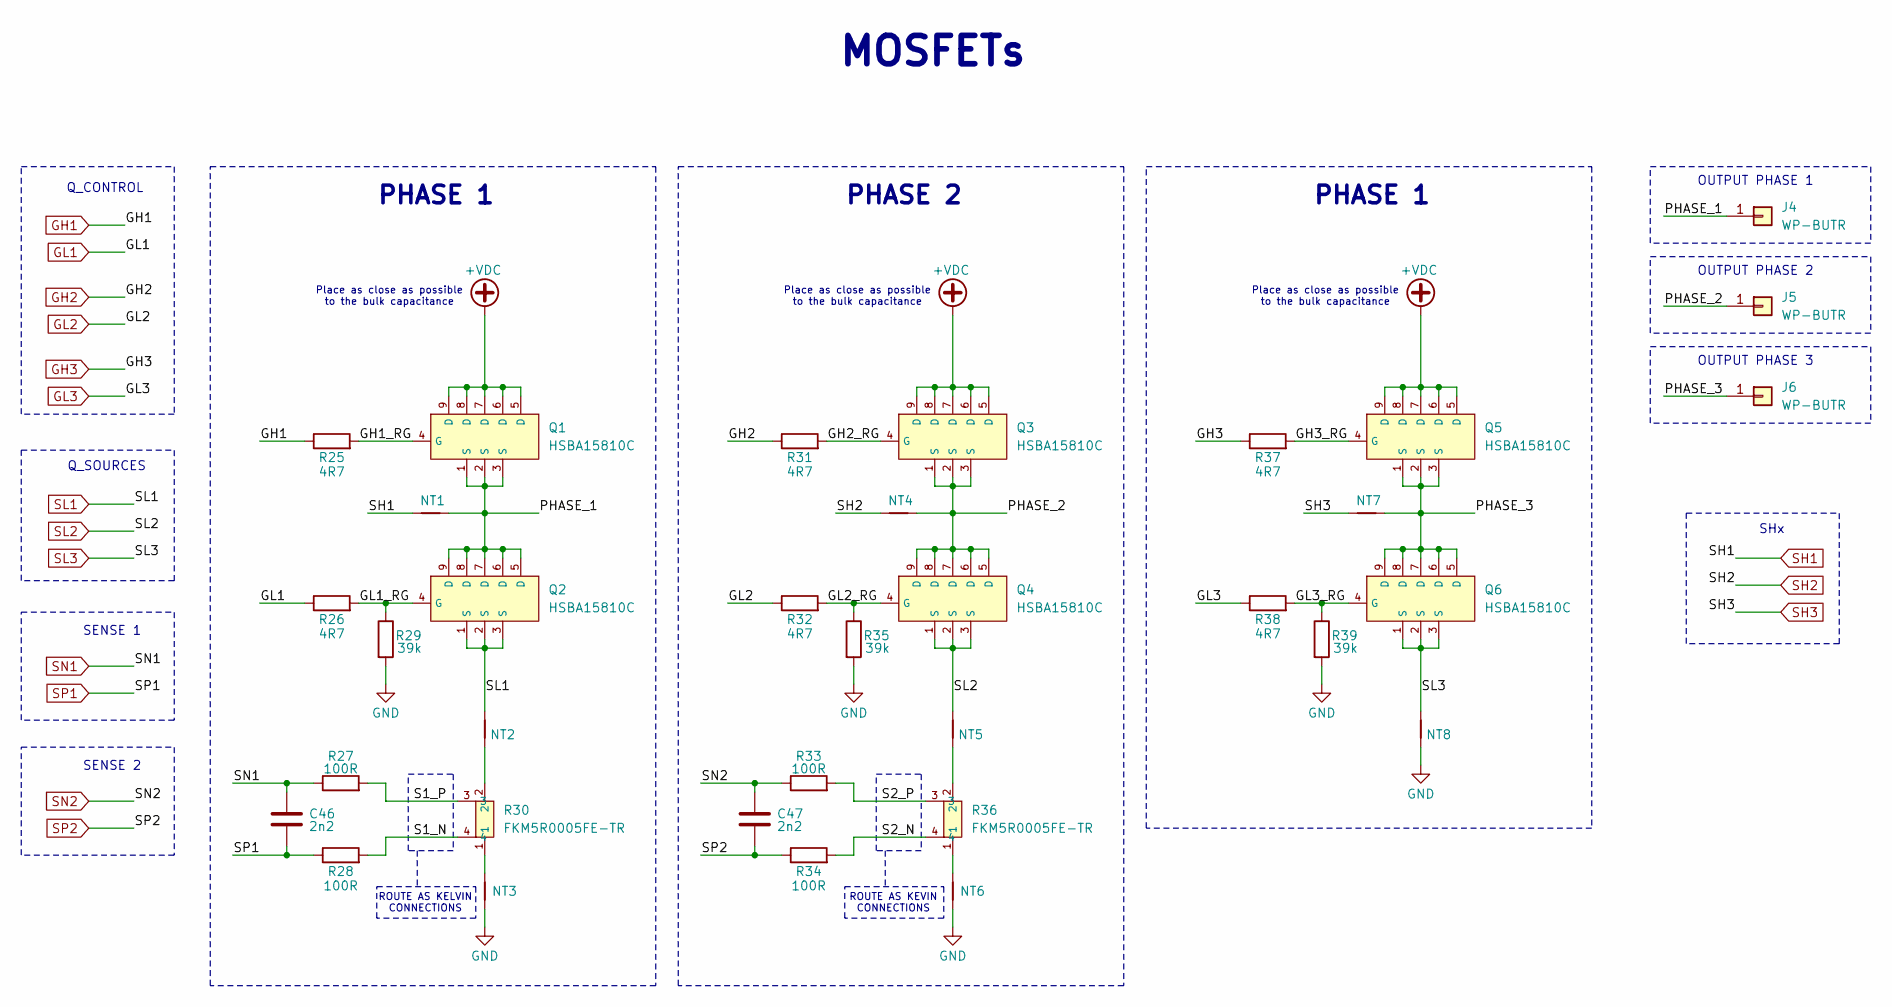
[picture p17: schematic MOSFETs.kicad_sch]

Parts:
C46, C47: 2n2; C_0603_1608Metric
J4, J5, J6: WP-BUTR; 7461084
NT1, NT2, NT5: NetTie_2; NetTie-2_SMD_Pad2.00mm_Small
NT3, NT4, NT6, NT7, NT8: NetTie_2; NetTie-2_SMD_Pad2.0mm
Q1, Q2, Q3, Q4, Q5, Q6: HSBA15810C; PQFN-8_L6.0-W5.0-P1.27-LS6.0-BL; LCSC C845605
R25, R26, R31, R32, R37, R38: 4R7; R_0603_1608Metric
R27, R28, R33, R34: 100R; R_0603_1608Metric
R29, R35, R39: 39k; R_0603_1608Metric
R30, R36: FKM5R0005FE-TR; RES-SMD_4P-L6.9-W6.6_OHMITE_FKM5RXXXXFE-TR; LCSC C2482696

Connections:
+VDC: Q1.5 (D), Q1.6 (D), Q1.7 (D), Q1.8 (D), Q1.9 (D), Q3.5 (D), Q3.6 (D), Q3.7 (D), Q3.8 (D), Q3.9 (D), Q5.5 (D), Q5.6 (D), Q5.7 (D), Q5.8 (D), Q5.9 (D); also elsewhere on the board
/MOSFETs/GH1_RG: Q1.4 (G), R25.2
/MOSFETs/GH2_RG: Q3.4 (G), R31.2
/MOSFETs/GH3_RG: Q5.4 (G), R37.2
/MOSFETs/GL1_RG: Q2.4 (G), R26.2, R29.1
/MOSFETs/GL2_RG: Q4.4 (G), R32.2, R35.1
/MOSFETs/GL3_RG: Q6.4 (G), R38.2, R39.1
/MOSFETs/PHASE_1: J4.1, NT1.2, Q1.1 (S), Q1.2 (S), Q1.3 (S), Q2.5 (D), Q2.6 (D), Q2.7 (D), Q2.8 (D), Q2.9 (D)
/MOSFETs/PHASE_2: J5.1, NT4.2, Q3.1 (S), Q3.2 (S), Q3.3 (S), Q4.5 (D), Q4.6 (D), Q4.7 (D), Q4.8 (D), Q4.9 (D)
/MOSFETs/PHASE_3: J6.1, NT7.2, Q5.1 (S), Q5.2 (S), Q5.3 (S), Q6.5 (D), Q6.6 (D), Q6.7 (D), Q6.8 (D), Q6.9 (D)
/MOSFETs/S1_N: R28.2, R30.4
/MOSFETs/S1_P: R27.2, R30.3
/MOSFETs/S2_N: R34.2, R36.4
/MOSFETs/S2_P: R33.2, R36.3
GH1: R25.1; also elsewhere on the board
GH2: R31.1; also elsewhere on the board
GH3: R37.1; also elsewhere on the board
GL1: R26.1; also elsewhere on the board
GL2: R32.1; also elsewhere on the board
GL3: R38.1; also elsewhere on the board
GND: NT3.1, NT6.1, NT8.1, R29.2, R35.2, R39.2; also elsewhere on the board
unnamed: NT2.1, R30.2
unnamed: NT3.2, R30.1
unnamed: NT5.1, R36.2
unnamed: NT6.2, R36.1
SH1: NT1.1; also elsewhere on the board
SH2: NT4.1; also elsewhere on the board
SH3: NT7.1; also elsewhere on the board
SL1: NT2.2, Q2.1 (S), Q2.2 (S), Q2.3 (S); also elsewhere on the board
SL2: NT5.2, Q4.1 (S), Q4.2 (S), Q4.3 (S); also elsewhere on the board
SL3: NT8.2, Q6.1 (S), Q6.2 (S), Q6.3 (S); also elsewhere on the board
SN1: C46.1, R27.1; also elsewhere on the board
SN2: C47.1, R33.1; also elsewhere on the board
SP1: C46.2, R28.1; also elsewhere on the board
SP2: C47.2, R34.1; also elsewhere on the board

Notes on the sheet:
ROUTE AS KEVIN CONNECTIONS
SENSE 1
Q_SOURCES
Place as close as possible to the bulk capacitance
SHx
PHASE 1
Q_CONTROL
${TITLE}
OUTPUT PHASE 1
OUTPUT PHASE 3
ROUTE AS KELVIN CONNECTIONS
OUTPUT PHASE 2
SENSE 2
PHASE 2

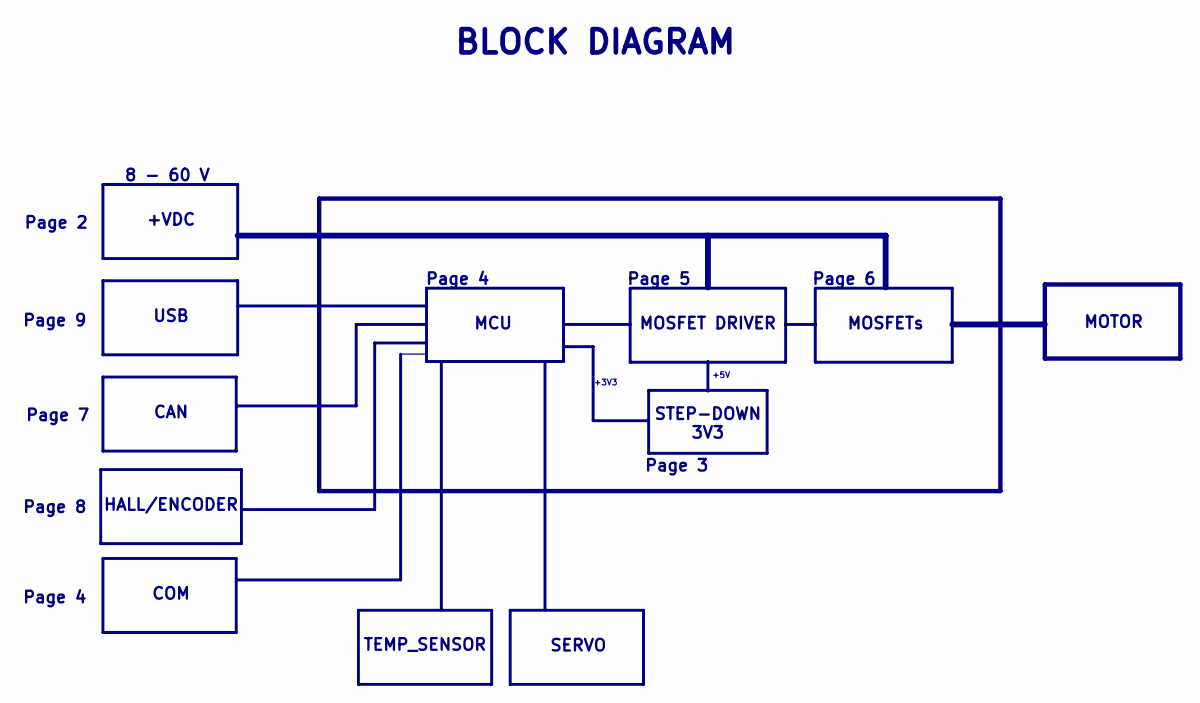
[picture p18: schematic block_diagram.kicad_sch, BLOCK DIAGRAM]

Notes on the sheet:
Page 5
Page 8
Page 6
Page 3
8 - 60 V
+3V3
Page 7
COM
MOTOR
USB
STEP-DOWN 3V3
Page 4
CAN
Page 2
${TITLE}
+VDC
MCU
+5V
MOSFET DRIVER
MOSFETs
SERVO
Page 9
HALL/ENCODER
TEMP_SENSOR

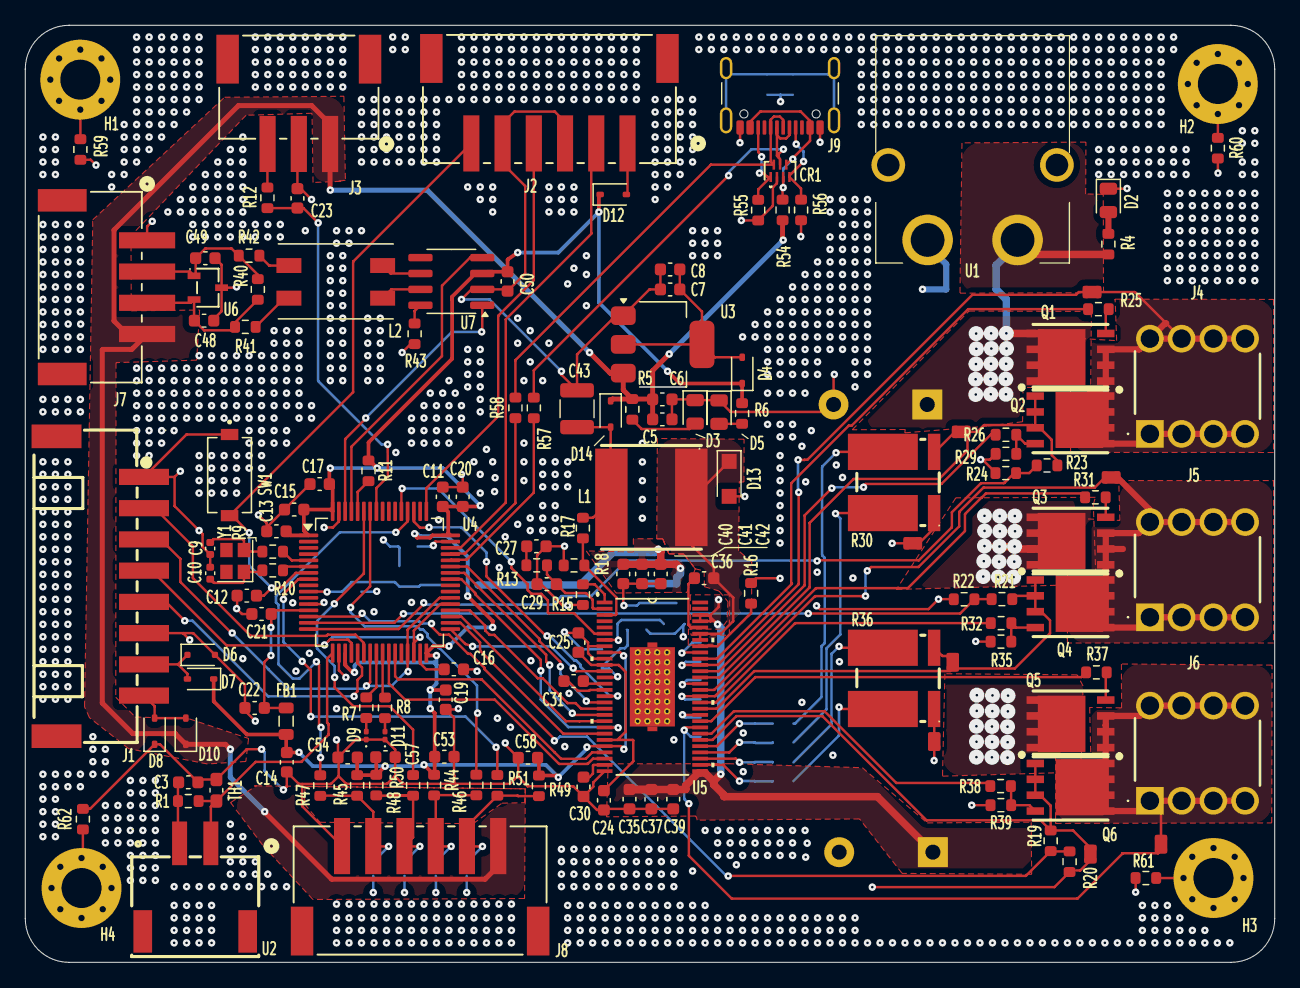
[picture p19: board ESC_rev0.kicad_pcb from above]

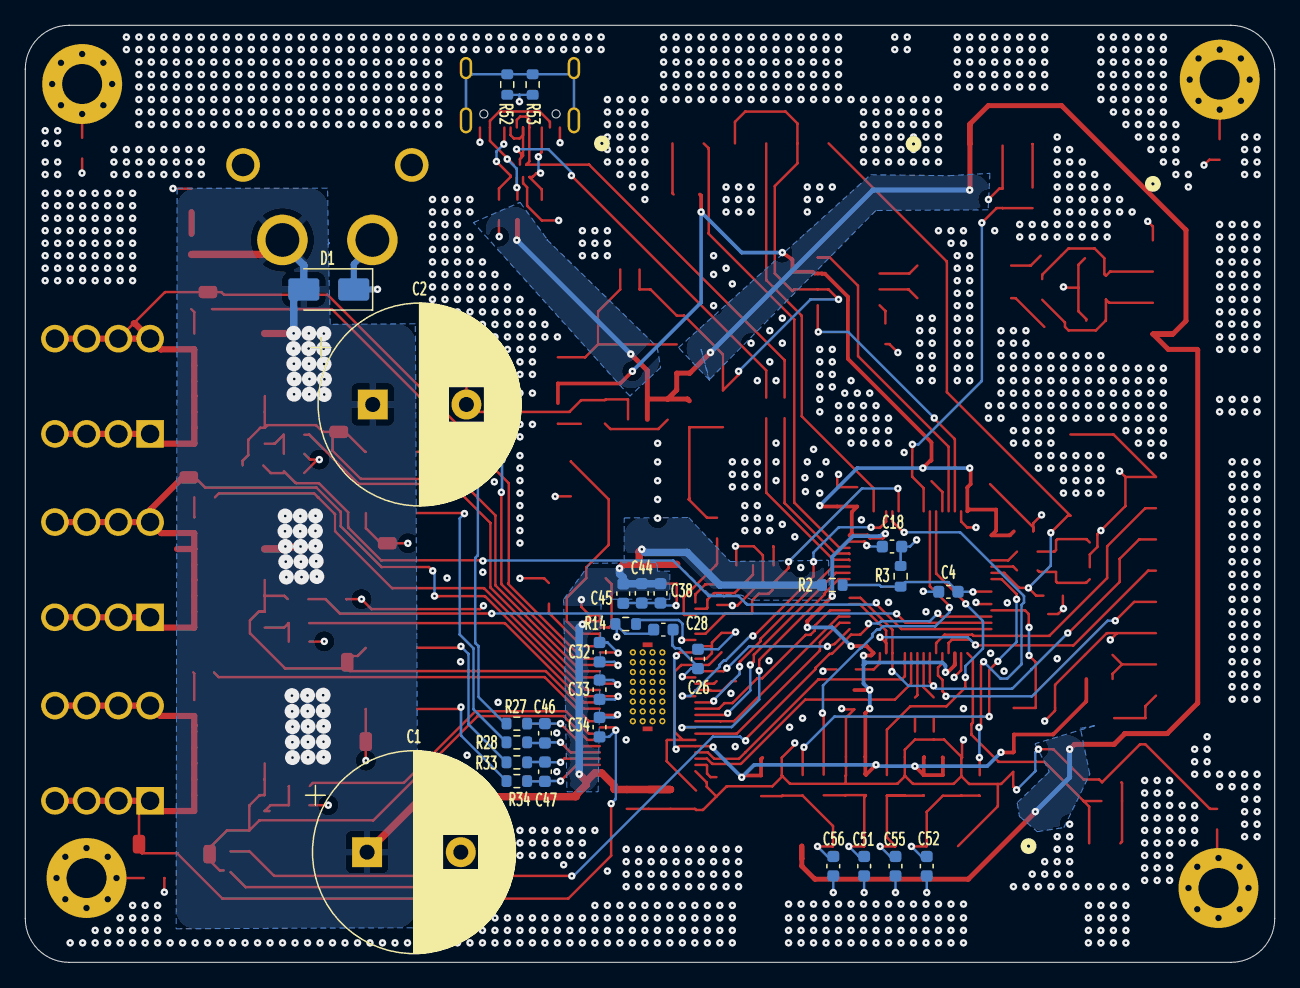
[picture p20: board ESC_rev0.kicad_pcb from below]

Board: 4 copper layers, 100.0 x 75.0 mm, 175 parts (28 on the bottom side), 128 nets.
