AndyBritoS/DC_Motor_Controller/(commit log)

2024-12-27 Update1
    Created kicad project and block diagram on schematics
    [CAN.kicad_sch, ESC_rev0.kicad_pcb, ESC_rev0.kicad_sch, MCU.kicad_sch, MOSFET_DRIVER.kicad_sch, MOSFETs.kicad_sch, block_diagram.kicad_sch, filters.kicad_sch]
2024-12-28 update2
    MCU sch
    [MCU.kicad_sch]
2024-12-29 update3
    Added DRV8302 footprint and started the Mosfet driver schematic.
    [MOSFET_DRIVER.kicad_sch]
2025-01-03 update4
    gate driver left side complete
    [MOSFET_DRIVER.kicad_sch]
2025-01-04 update 5
    gate driver right side
    [MOSFET_DRIVER.kicad_sch]
2025-01-05 update 6
    gate driver completion and mosfet init
    [ESC_rev0.kicad_sch, MOSFET_DRIVER.kicad_sch, MOSFETs.kicad_sch]
2025-01-05 update 7
    mosfet page completion
    [MOSFET_DRIVER.kicad_sch, MOSFETs.kicad_sch]
2025-01-06 update 8
    conclusion of mosfets and input protection; can almost concluded
    [CAN.kicad_sch, ESC_rev0.kicad_sch, MCU.kicad_sch, input_protection.kicad_sch]
2025-01-07 update 9
    filters and USB complete
    [ESC_rev0.kicad_sch, MOSFET_DRIVER.kicad_sch, USB.kicad_sch, filters.kicad_sch]
2025-01-07 update10
    modifications to root page, completion of pages step_down and mechanical
    [ESC_rev0.kicad_sch, MCU.kicad_sch, MOSFET_DRIVER.kicad_sch, Mechanical.kicad_sch, USB.kicad_sch, block_diagram.kicad_sch, input_protection.kicad_sch, step_down.kicad_sch]
2025-01-07 update11
    root page base complete
    [ESC_rev0.kicad_sch]
2025-01-08 UPDATE 12
    started schematics revision: edit and added info and circuits to some pages and assigned some footprints for components
    [CAN.kicad_sch, MCU.kicad_sch, MOSFET_DRIVER.kicad_sch, MOSFETs.kicad_sch, Mechanical.kicad_sch, USB.kicad_sch, block_diagram.kicad_sch, filters.kicad_sch]
2025-01-17 update 13
    assigned all footprints (provisionally) and imported them - errors and warning occurred, must be corrected in the future
    [CAN.kicad_sch, ESC_rev0.kicad_pcb, MCU.kicad_sch, MOSFET_DRIVER.kicad_sch, MOSFETs.kicad_sch, Mechanical.kicad_sch, USB.kicad_sch, filters.kicad_sch]
2025-01-18 update 14
    Circuits separated by schematic pages. Replaced crystal footprint.
    [ESC_rev0.kicad_pcb, MCU.kicad_sch]
2025-01-20 update 15
    Simple connectors replaced by smd connectors (downloaded). Connectors were placed in edges of the board.
    [CAN.kicad_sch, ESC_rev0.kicad_pcb, MCU.kicad_sch, Mechanical.kicad_sch, filters.kicad_sch, input_protection.kicad_sch]
2025-01-21 update 16
    All components placed on board. Some components modifications and addition were made: added 3D models, changed some symbols and footprints positions and some component types.
    [CAN.kicad_sch, ESC_rev0.kicad_pcb, MCU.kicad_sch, MOSFET_DRIVER.kicad_sch, MOSFETs.kicad_sch, Mechanical.kicad_sch, USB.kicad_sch, filters.kicad_sch]
2025-01-22 update 17
    Defined board stackup, constraints and net classes for USB and CAN. Some components were slightly moved; shunt filters were place next do the gate driver pins. External calculators were used, check course documentation.
    [ESC_rev0.kicad_pcb]
2025-01-23 update 18
    Route process partially complete. Some corrections were made in footprints and pins references. Probably the power lines will need changes in size.
    [ESC_rev0.kicad_pcb, MCU.kicad_sch, MOSFET_DRIVER.kicad_sch, filters.kicad_sch, input_protection.kicad_sch]
2025-01-23 update 19
    Preliminary routing finished, all signaling connections made.
    [ESC_rev0.kicad_pcb, MCU.kicad_sch]
2025-01-24 update 20
    Tracing complete (some power tracks need to be validated and some others optimizations weren't made). All connections were made, reference planes created, copper pour on mosfets and other power pads (not all). Some tracks were modified. References visible and apparently ok (it's just demo). Stitching vias were applied all over the board. Informative texts and symbols weren't included.
    [ESC_rev0.kicad_pcb]
2025-01-27 update 21
    DRC checked, all problems solved. Created Custom Rules to following JLCPCB most important capabilities. Relevant modifications on tracks, components positions and to copper pours were made. Board images were updated in the schematics.
    [CAN.kicad_sch, ESC_rev0.kicad_pcb, ESC_rev0.kicad_sch, MCU.kicad_sch, MOSFET_DRIVER.kicad_sch, MOSFETs.kicad_sch, Mechanical.kicad_sch, USB.kicad_sch]
2025-01-27 update 22
    Board complete - not perfect for production, it is just a demo. Generated gerber files through extensions, prepared some layout infos, updated the schematics with images. Note: due to a power outage, the last update had conflicts and the push was forced.
    [ESC_rev0.kicad_pcb, ESC_rev0.kicad_sch, Mechanical.kicad_sch]
